Srabon-bot/Aquaguard/new_models/new_approach/model_1_flood/AquaShield_Capstone_Project_Report_Humanized.md

 AquaShield: Intelligent Aquaculture Monitoring and
Adaptive Protection System Using Machine Learning and
                          IoT
                                                 By

                   Md. Shahriar Hossain Srabon (ID: 0432310005101056)
                             Md. Mahfuz (ID: 0432310005101057)
                             Hrithik Saha (ID: 0432310005101071)

                      Department of Computer Science and Engineering

                              Faculty of Science and Engineering

A Capstone Project Submitted in partial fulfillment of the requirements for the degree of Bachelor of
                           Science in Computer Science and Engineering

                                          Supervised By

                                     Sultana Rokeya Naher

                                        Associate Professor

                         Department of Computer Science and Engineering

             University of Information Technology and Sciences (UITS)
                                  Baridhara J Block, Dhaka 1212

                                           October, 2026

Declaration
The capstone project work entitled "AquaShield: Intelligent Aquaculture Monitoring and
Adaptive Protection System Using Machine Learning and IoT" is a authentic record of work
carried out by Md. Shahriar Hossain Srabon (ID: 0432310005101056), Md. Mahfuz (ID:
0432310005101057), and Hrithik Saha (ID: 0432310005101071) under the supervision of
Sultana Rokeya Naher, Associate Professor, Department of Computer Science and Engineering
(CSE), University of Information Technology and Sciences (UITS), Dhaka, Bangladesh.

This work, in whole or in part, has not been submitted elsewhere for the award of any degree or
diploma.

Candidates:

------------------------------------------------------------------------

➢ Md. Shahriar Hossain Srabon

Student ID: 0432310005101056

Department of Computer Science and Engineering, UITS

------------------------------------------------------------------------

➢ Md. Mahfuz

Student ID: 0432310005101057

Department of Computer Science and Engineering, UITS

------------------------------------------------------------------------

➢ Hrithik Saha

Student ID: 0432310005101071

Department of Computer Science and Engineering, UITS

Approval
This is to certify that the capstone project work submitted by Md. Shahriar Hossain Srabon
(ID: 0432310005101056), Md. Mahfuz (ID: 0432310005101057), and Hrithik Saha
(ID: 0432310005101071) entitled "AquaShield: Intelligent Aquaculture Monitoring and Adaptive
Protection System Using Machine Learning and IoT" has been examined and approved by the
Capstone Project Review Committee in partial fulfillment of the requirements for the degree of
Bachelor of Science in Computer Science and Engineering (CSE) in the Department of Computer
Science and Engineering (CSE), University of Information Technology and Sciences (UITS),
Dhaka, Bangladesh in Autumn 2026.

                                                          2

CAPSTONE PROJECT REVIEW COMMITTEE

➢ ................................................................

[Head of Department Name]

Head of the Department

Department of Computer Science and Engineering (CSE)

University of Information Technology and Sciences (UITS)

(Convener)

➢ ................................................................

Sultana Rokeya Naher

Associate Professor

Department of Computer Science and Engineering (CSE)

University of Information Technology and Sciences (UITS)

(Supervisor)

➢ ................................................................

[External Examiner Name]

Professor / External Expert

Department of Computer Science and Engineering

University of Information Technology and Sciences (UITS)

(Member)

➢ ................................................................

[Internal Coordinator Name]

Coordinator, Capstone Project Committee

Department of Computer Science and Engineering (CSE)

University of Information Technology and Sciences (UITS)

(Member Secretary)

                                                                      3

Acknowledgement - done

We would like to express our gratitude to Almighty Allah for providing us with the patience,
health and capacity to finish our capstone engineering project.

We would like to thank our supervisor Sultana Rokeya Naher, Associate Professor, Computer
Science and Engineering, University of Information Technology and Sciences (UITS) for her
guidance and support. Her constant guidance, frequent feedback and encouragement helped us to
tackle the actual hardware problems, design the right database and validate our machine learning
models properly.

We are also grateful to the Head of the Department of Computer Science and Engineering, and
our teachers and laboratory staff at UITS for the support and facilities provided to us during the
study in the Department.

The Bangladesh Water Development Board (BWDB) and Flood Forecasting and Warning Centre
(FFWC) have been providing historical records of river gauges, which is greatly appreciated. We
also would like to thank Open-Meteo for supplying the free catchment rainfall data from ERA5.

Last but not the least, we would like to thank our parents and relatives for their constant support
and sacrifices throughout our college days. We also thank each other for working together as a
team with dedication to build AquaShield.

Justification Report
Below is the Course Outcome to Program Outcome (CO-PO) Mapping, Justification of PO
through COs, Complex Engineering Problem (CEP) Justification, and Range of Complex
Engineering Activities (CEA) Report for our project titled "AquaShield: Intelligent Aquaculture
Monitoring and Adaptive Protection System Using Machine Learning and IoT".

CO-PO Mapping
CO-PO Mapping Matrix for AquaShield

  CO No.             Description of CO        KP               CP              CA
                     Apply engineering
                     fundamentals and
                     computing
                     knowledge to
                     identify and translate
                     real-life aquaculture
  CO1                                         K1, K2, K3, K4   -               -
                     water quality
                     problems and
                     monsoon flood
                     threats into an
                     intelligent IoT and
                     ML solution.

                                                      4

CO No.   Description of CO       KP           CP              CA
         Identify, formulate,
         and analyze water
         quality requirements
         (pH, TDS,
         temperature, depth)
CO2                              K2, K3, K4   WP1, WP2, WP3   -
         and flood threshold
         limits to reach
         substantiated
         conclusions using
         data.
         Design and build an
         integrated system
         combining an ESP32
         sensor node, local
CO3      relay control logic,    K3, K5, K6   WP1, WP3, WP5   -
         cloud data storage,
         and machine
         learning prediction
         models.
         Select and apply
         modern hardware
         and software tools
         including ESP32,
         Arduino C++,
CO4                              K3, K5, K6   WP1, WP3, WP4   -
         Firebase Realtime
         Database, Python
         FastAPI,
         Scikit-learn, and
         XGBoost.
         Function effectively
         as individual
         contributors and as a
         3-member
CO5                              -            -               -
         engineering team
         with clear task
         distribution and
         regular coordination.
         Demonstrate project
         management and
         budgeting skills by
         keeping the total
CO6                              -            -               -
         prototype hardware
         cost under 7,200
         BDT (~\$60) for
         rural fish farmers.
         Conduct
         experimental
         investigations using
         laboratory buffer
         solutions for sensor
CO7                              K6, K8       WP1, WP2, WP3   -
         calibration and 15
         years of river data
         with
         Leave-One-Year-Out
         validation.
         Assess the
         real-world impact of
         the project on rural
         aquaculture,
CO8                              K8, K7       WP1, WP3, WP4   -
         protecting fish from
         mortality and saving
         farmers from severe
         financial loss.

                                          5

  CO No.            Description of CO       KP       CP                  CA
                    Evaluate
                    environmental
                    sustainability by
                    minimizing water
  CO9               pumping, preventing     K7       -                   -
                    chemical
                    over-concentration,
                    and avoiding feed
                    wastage.
                    Commit to
                    professional
                    engineering ethics by
                    reporting true
                    empirical results,
  CO10                                      K7       -                   -
                    citing all references
                    properly, and
                    explaining model
                    predictions with
                    SHAP.
                    Communicate
                    engineering work
                    clearly through a
                                                                         EA1, EA2, EA3,
  CO11              complete written        -        -
                                                                         EA5
                    technical project
                    book and oral
                    defense presentation.
                    Recognize the need
                    for lifelong learning
                    by researching future
                    system extensions
  CO12                                      -        -                   -
                    like on-device
                    TinyML and
                    LoRaWAN wireless
                    networks.

Justification of PO through COs
Justification of PO through COs for AquaShield

                                                          Justification (with Specific Report
  CO No.                           PO
                                                          References)
                                                          We applied basic electronics, sensor
                                                          physics (Nernst equation for pH,
                                                          electrical conductivity for TDS,
                                                          ultrasonic time-of-flight), and
  CO1                              PO1                    machine learning regression to solve
                                                          real-world pond water deterioration
                                                          and river flood overflow in
                                                          Bangladesh. (Reported in Section
                                                          1.2, 3.3, and 3.6).
                                                          We formulated the technical
                                                          requirements for pond water
                                                          monitoring and river flood warnings,
                                                          defining mathematical conversion
  CO2                              PO2                    formulas, 1-hour TDS lag features,
                                                          and water danger thresholds
                                                          evaluated using RMSE, MAE, and
                                                          NSE metrics. (Reported in Section
                                                          1.3, 3.6, and 5.3).

                                                 6

                    Justification (with Specific Report
CO No.   PO
                    References)
                    We designed and assembled the
                    complete system: an ESP32 edge
                    node with optocoupler-isolated
                    relays, local autonomous FSM rules
                    for the pumps and the servo feeder, a
CO3      PO3
                    Firebase Realtime Database cloud
                    layer, and three machine learning
                    models served by a Python FastAPI
                    backend. (Reported in Chapters 3
                    and 4).
                    We selected and used standard
                    modern engineering tools including
                    ESP32 32-bit MCU,
                    PlatformIO/Arduino IDE, Firebase
CO4      PO5
                    Realtime Database, Python FastAPI,
                    Python Scikit-learn, XGBoost, and
                    SHAP. (Reported in Section 4.2 to
                    4.6).
                    Our 3-member team divided tasks
                    effectively: Srabon handled hardware
                    fabrication and power wiring,
                    Mahfuz integrated the ESP32 with
                    the Firebase Realtime Database and
CO5      PO9
                    built the web dashboard, and Hrithik
                    developed the Python FastAPI
                    backend and the ML flood
                    forecasting and anomaly detection
                    models. (Reported in Section 4.1).
                    We managed component
                    procurement and prepared a detailed
                    Bill of Materials totaling 6,570 BDT
CO6      PO11       (\$55.15 USD), proving our system is
                    affordable for marginal fish farmers
                    in Bangladesh. (Reported in Section
                    3.3, Table 3.1).
                    We conducted practical
                    investigations: we calibrated the pH
                    sensor with vinegar (pH 2.4) and
                    baking soda (pH 8.3) reference
                    solutions, evaluated sensor accuracy
                    against standard buffer solutions, and
CO7      PO4
                    validated our river flood model on 15
                    years (2008--2022) of BWDB
                    records using Leave-One-Year-Out
                    (LOYO) cross-validation to prevent
                    data leakage. (Reported in Section
                    3.3, 3.7, 5.2, and 5.3).
                    We evaluated the socioeconomic
                    impact on rural communities:
                    preventing fish kills protects farmer
                    income, safeguards food security,
CO8      PO6
                    and avoids financial devastation
                    during monsoon river overflows.
                    (Reported in Section 1.1, 2.2, and
                    6.1).
                    We designed closed-loop control
                    rules that save water by pumping
                    only when necessary, prevent pond
CO9      PO7        pollution from excess feed, and use
                    energy-efficient 12V DC power
                    components. (Reported in Section
                    3.4 and 4.2).

                7

                                                                   Justification (with Specific Report
  CO No.                       PO
                                                                   References)
                                                                   We maintained academic honesty by
                                                                   using real observed datasets,
                                                                   reporting actual prediction errors
  CO10                         PO8                                 without bias, explaining tree
                                                                   predictions via SHAP, and properly
                                                                   citing all literature. (Reported in
                                                                   Section 5.4, 5.7, and References).
                                                                   We wrote this complete,
                                                                   well-documented technical capstone
                                                                   report adhering to UITS and IEEE
                                                                   standards, created 13 figures (Figure
  CO11                         PO10
                                                                   3.1 to Figure 5.11) and 15 numbered
                                                                   tables, and prepared slides for our
                                                                   oral defense. (Reported throughout
                                                                   the entire book and the report).
                                                                   We recognized that technology
                                                                   continues to evolve, so we studied
                                                                   and documented future upgrade paths
  CO12                         PO12                                including running TinyML directly
                                                                   on the ESP32 and adding LoRaWAN
                                                                   mesh networking. (Reported in
                                                                   Section 6.2).

Complex Engineering Problem (CEP) Justification
Complex Engineering Problem (CEP) Justification Matrix

                                                                   BAETE Criteria [24] & Project
  Attribute Category           Attribute Name & ID                 Justification (with Report
                                                                   References)
                                                                   Solving this problem required
                                                                   knowledge from multiple
                                                                   engineering fields (K4): embedded
                                                                   systems (ADC oversampling,
                                                                   voltage-divider interfacing, 3.3V
                                                                   analog sensor design), cloud data
                                                                   handling (Firebase Realtime
  1. Mandatory Attribute       Depth of Knowledge (P1)             Database, Python FastAPI REST
                                                                   services), time-series machine
                                                                   learning, and Explainable AI
                                                                   (SHAP). We studied research
                                                                   literature (K8) to handle time-series
                                                                   data leakage and peak extrapolation.
                                                                   (Reported in Section 2.4, 2.5, 3.6,
                                                                   5.3).
                                                                   We balanced conflicting constraints:
                                                                   low hardware cost (<\$60) vs. good
                                                                   sensor accuracy; real-time cloud
                               Range of Conflicting Requirements   updates vs. frequent rural internet
  2. Supporting Attribute
                               (P2)                                dropouts; and long flood forecast
                                                                   horizons (+14 days) vs. growing
                                                                   prediction error. (Reported in Section
                                                                   1.2, 3.4, 5.6).

                                               8
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
