Srabon-bot/Aquaguard/new_models/AquaGuard — Machine Learning Module PRD.md

## AquaGuard — Machine Learning Module

## Product Requirements Document (PRD)

Project: AquaGuard — Bangladesh Flood Early Warning and IoT Pond Management System

Document Type: Machine Learning Module PRD

Primary Users: Aquaculture farmers / pond operators

Implementation Level: Undergraduate / beginner-friendly ML project

Target: A practical, explainable ML system integrated with the existing AquaGuard IoT dashboard

## 1. Project Overview

AquaGuard is an IoT-based pond-management and flood-awareness system for aquaculture environments in Bangladesh.

The existing system contains:

- ESP32-based pond monitoring

- pH sensing

- TDS/water-quality sensing
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
