Srabon-bot/Aquaguard/added figs/1.1.png

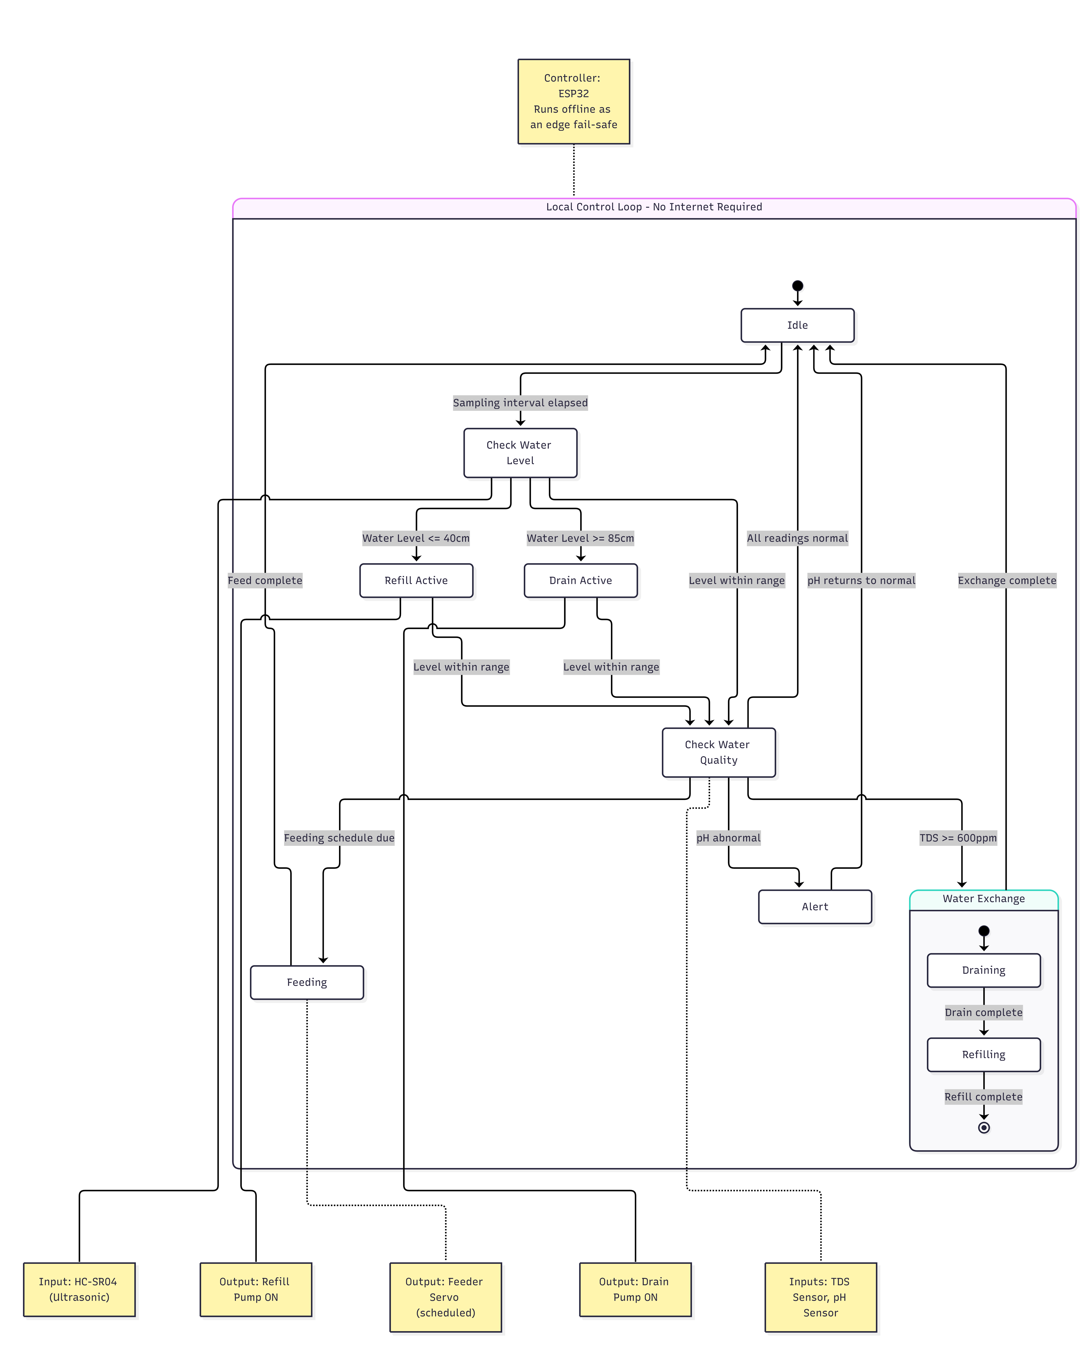
added figs/1.1.png
