Srabon-bot/Aquaguard/added figs/1.2.png

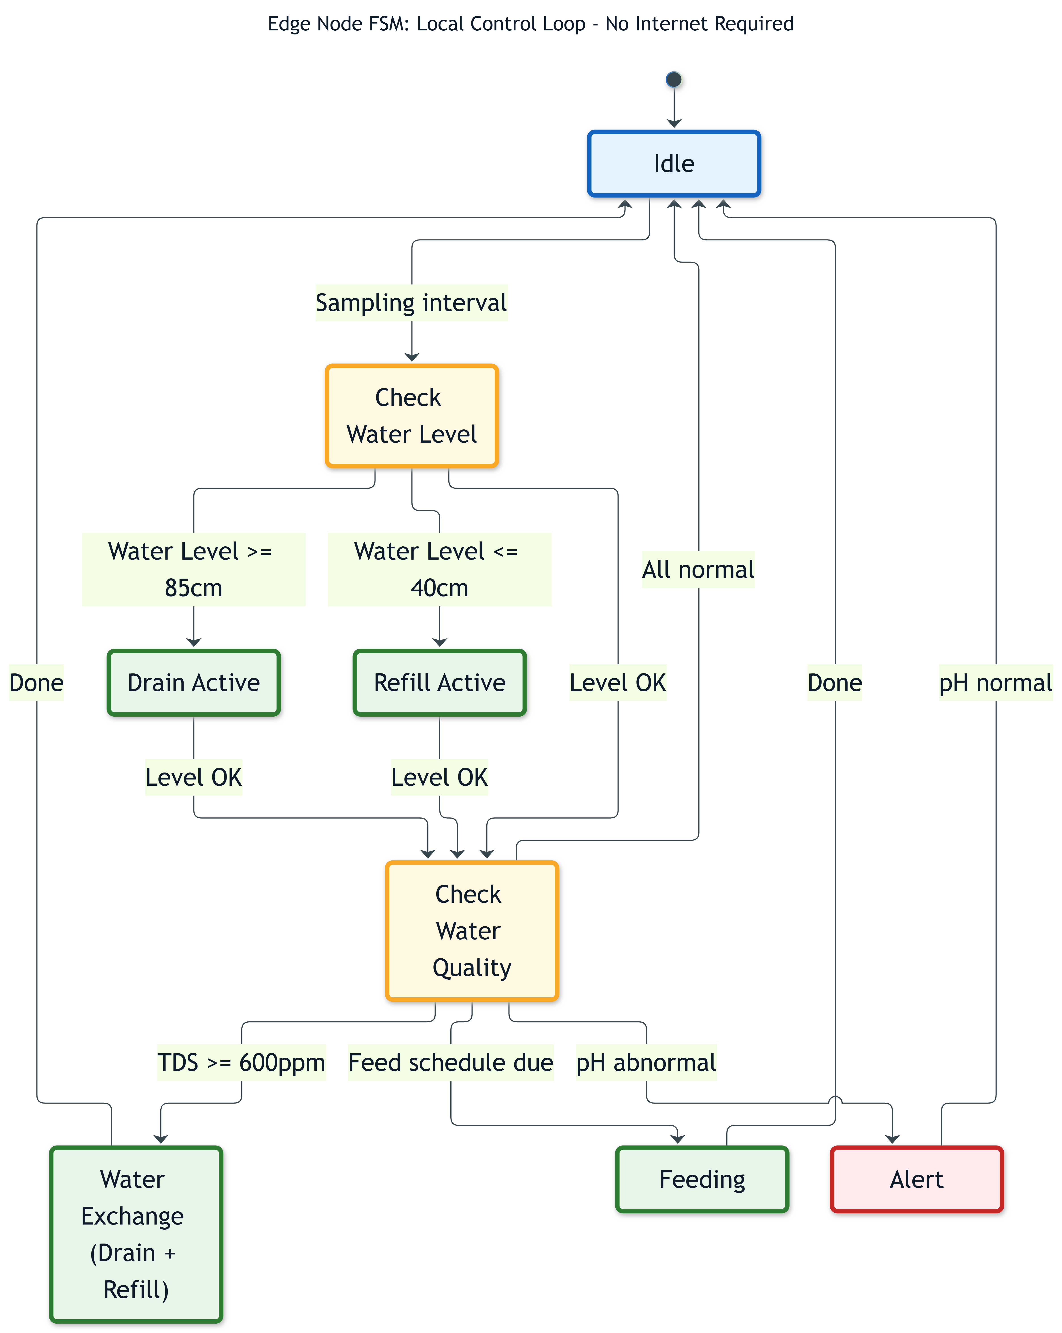
added figs/1.2.png
