Srabon-bot/Aquaguard/added figs/2.1.r-2026-10-06-072004.png

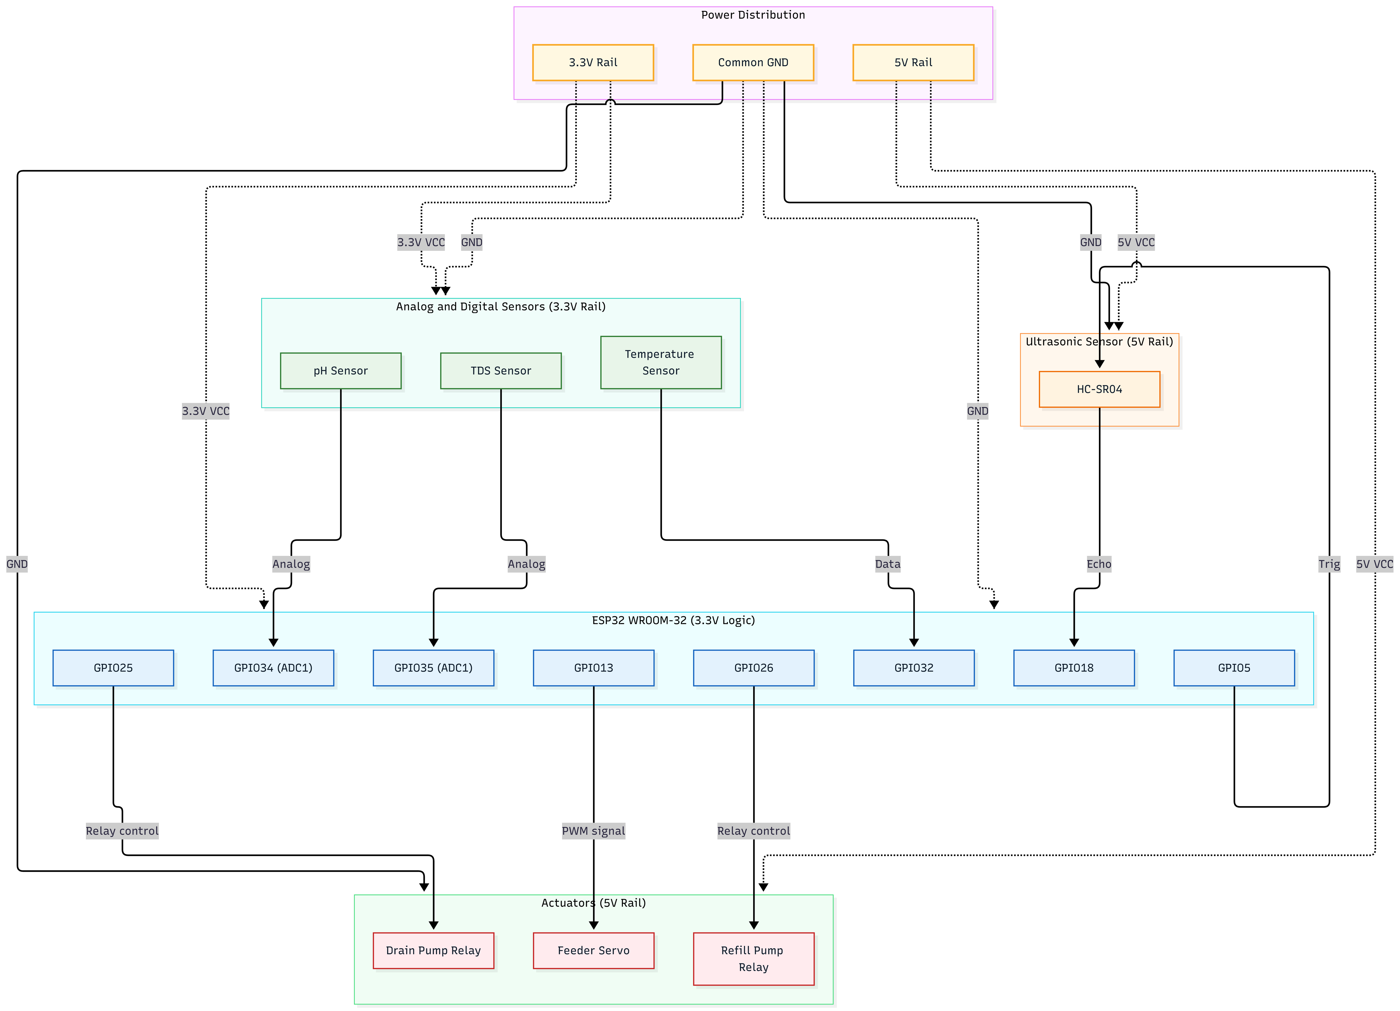
added figs/2.1.r-2026-10-06-072004.png
