Srabon-bot/Aquaguard/added figs/2.2.p-2026-10-06-072031.png

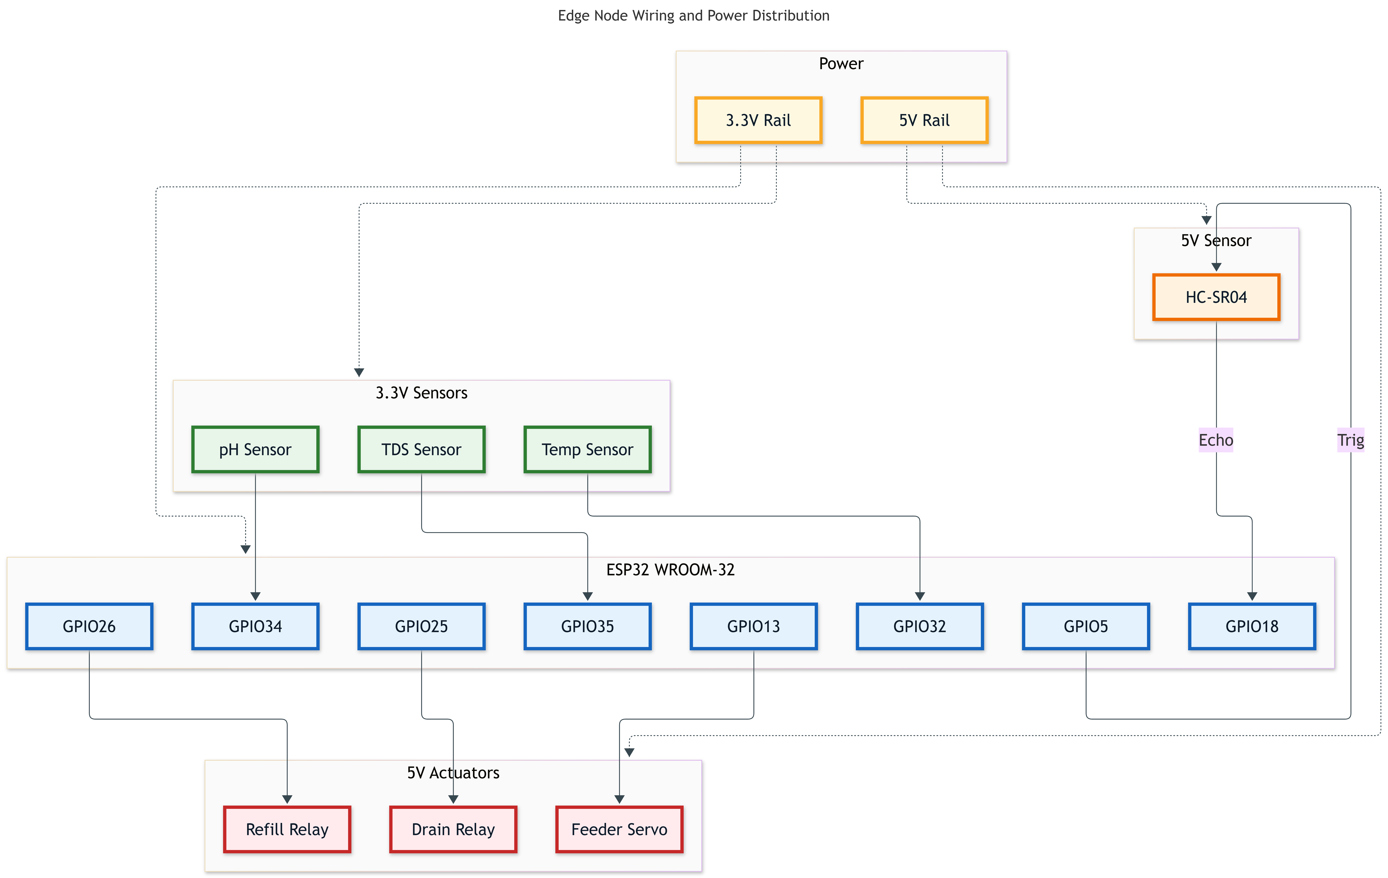
added figs/2.2.p-2026-10-06-072031.png
