Srabon-bot/Aquaguard/added figs/3.1.r-2026-10-06-072122.png

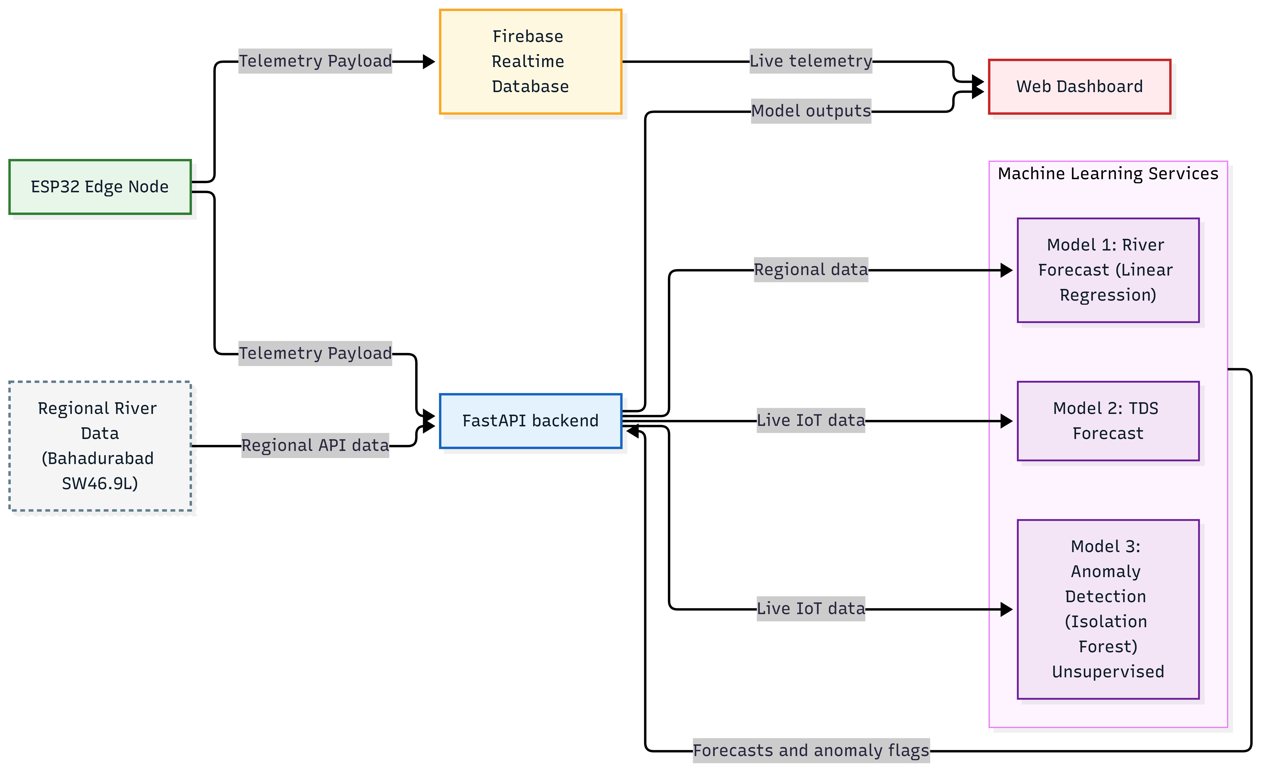
added figs/3.1.r-2026-10-06-072122.png
