Srabon-bot/Aquaguard/added figs/3.2.p-2026-10-06-072148.png

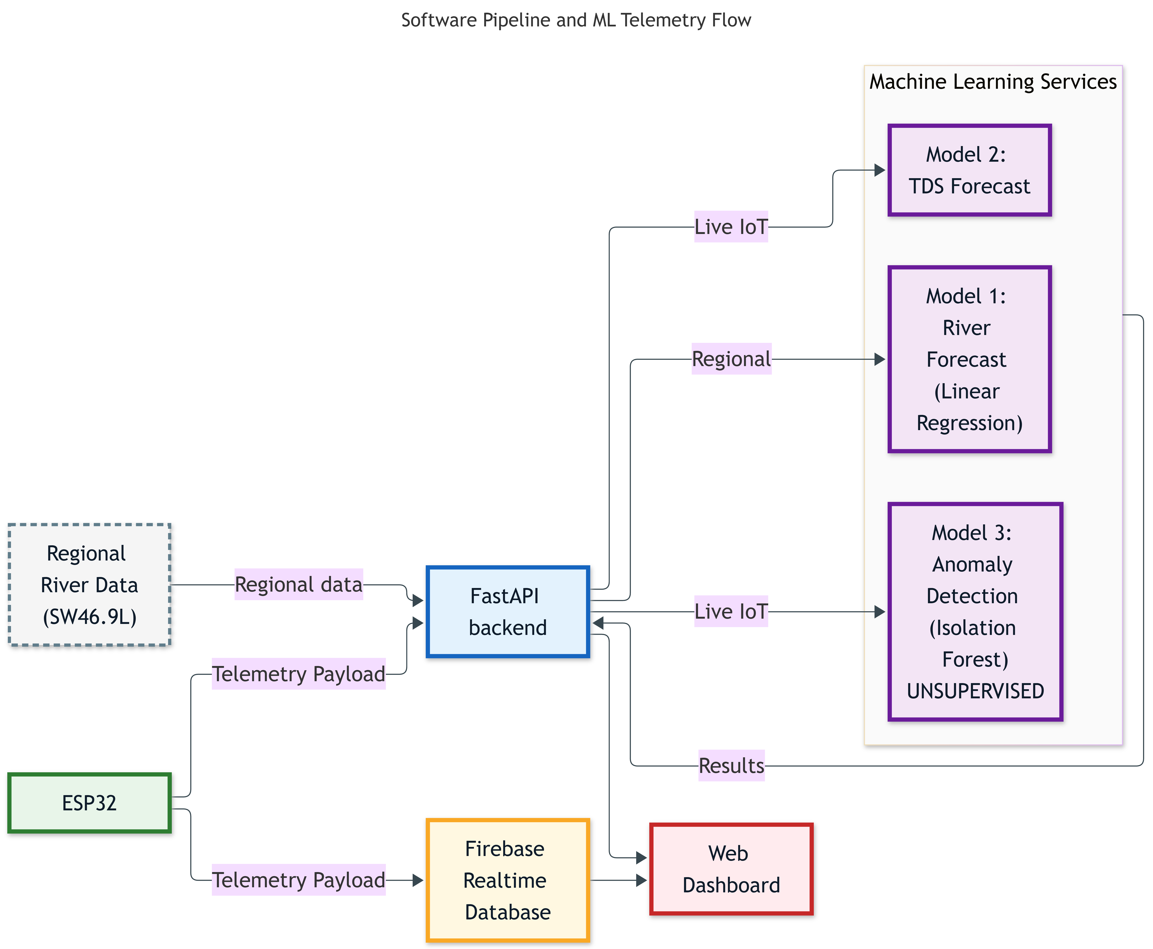
added figs/3.2.p-2026-10-06-072148.png
