Srabon-bot/Aquaguard/added figs/5.1.R-2026-10-06-071544.png

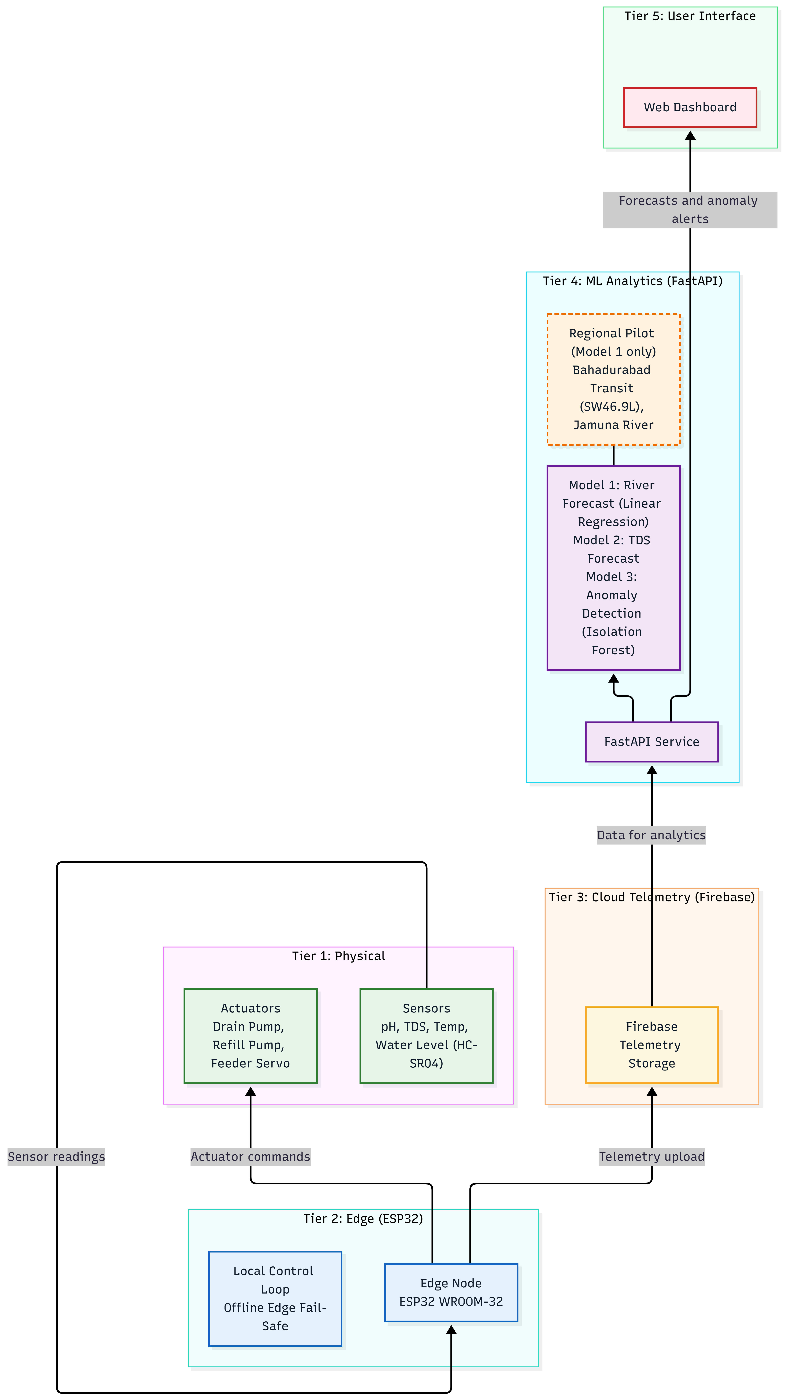
added figs/5.1.R-2026-10-06-071544.png
