Srabon-bot/Aquaguard/added figs/5.2.p-2026-10-06-071613.png

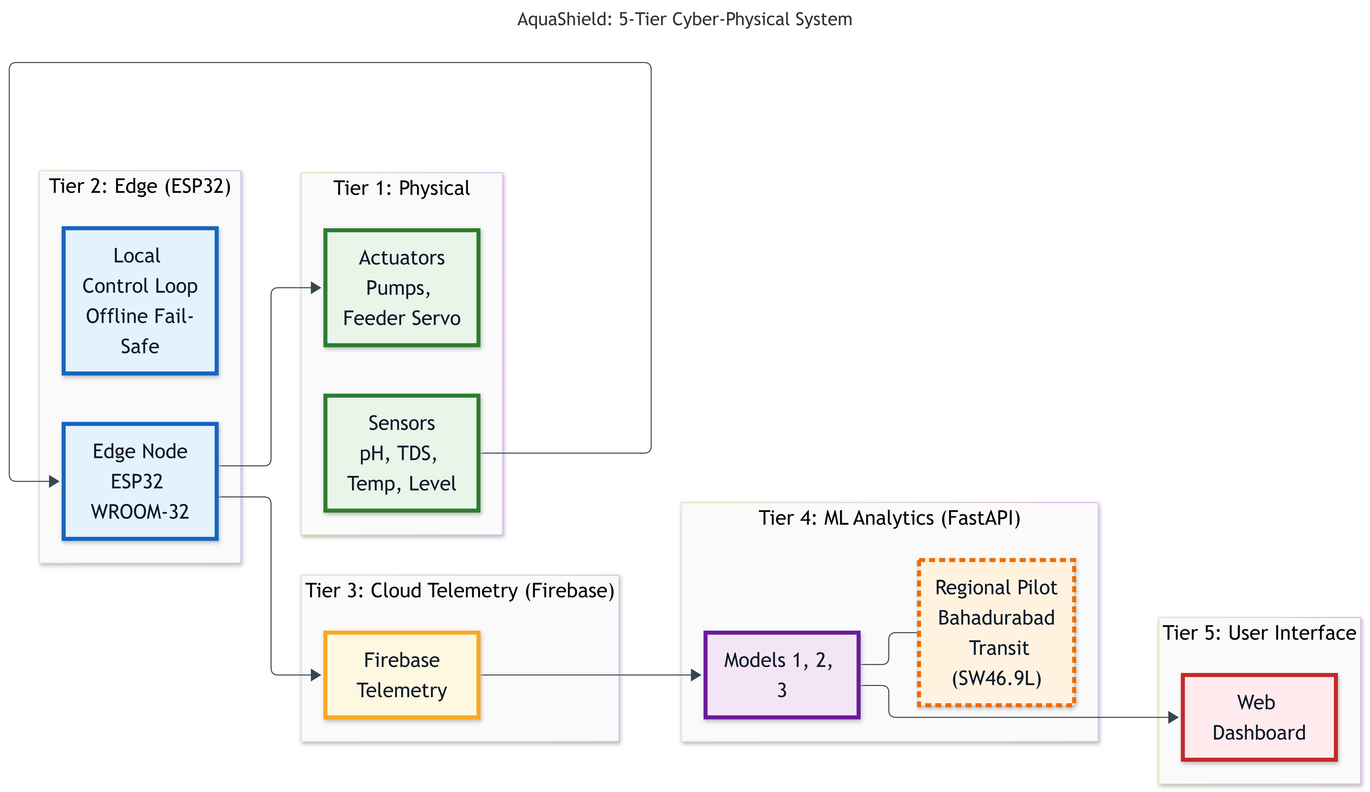
added figs/5.2.p-2026-10-06-071613.png
