Srabon-bot/Aquaguard/AquaGuard_Final_Release/software/backend/model_1_flood/outputs/figures/F01_full_wl_series.png

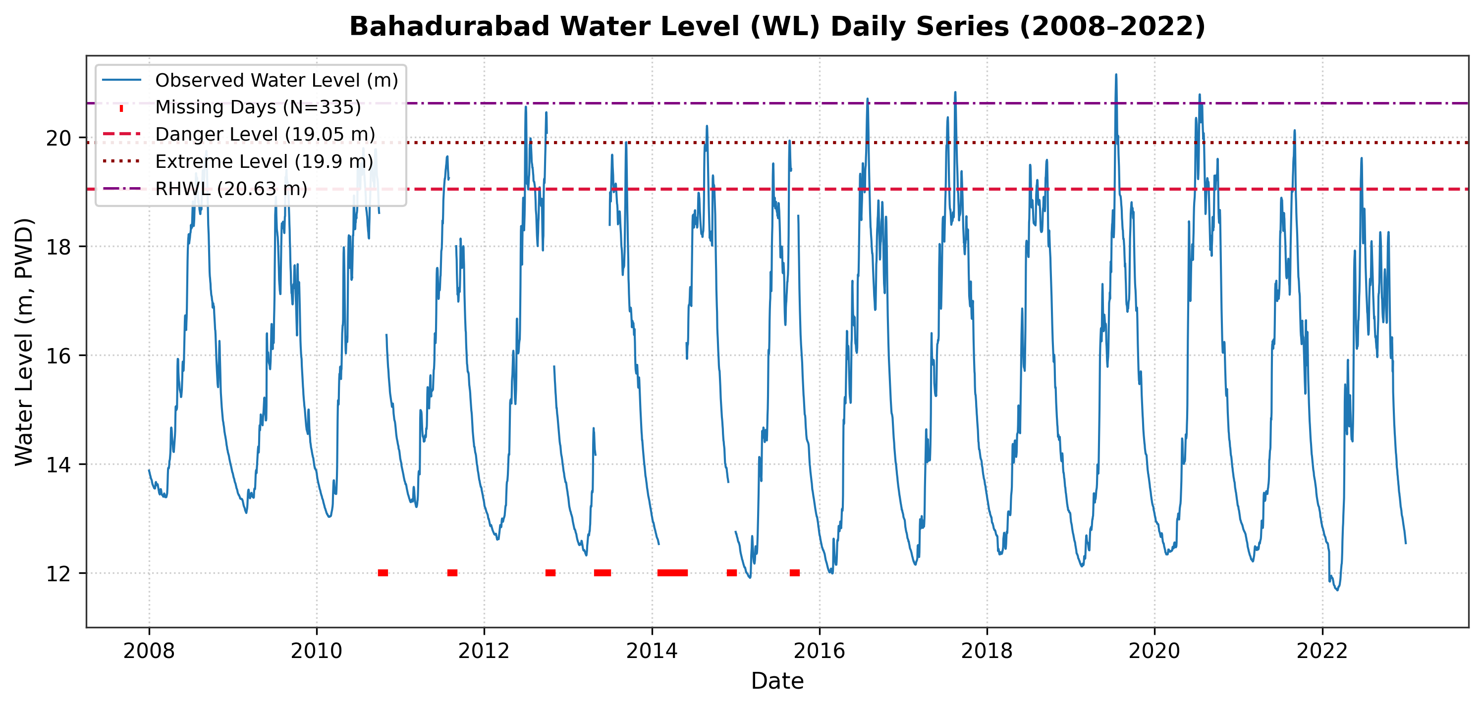
AquaGuard_Final_Release/software/backend/model_1_flood/outputs/figures/F01_full_wl_series.png
