Srabon-bot/Aquaguard/AquaGuard_Final_Release/software/backend/model_1_flood/outputs/figures/F02_missing_data_heatmap.png

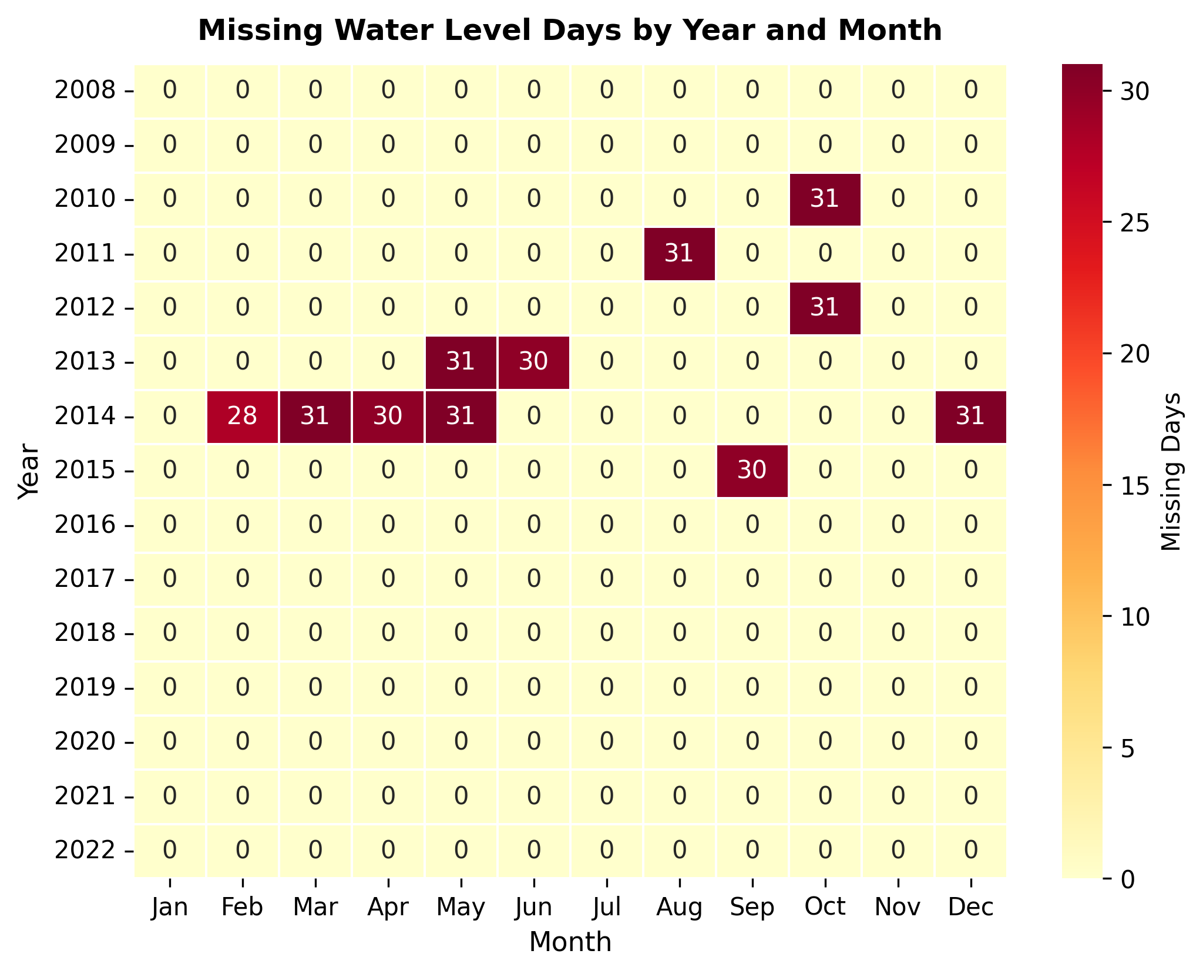
AquaGuard_Final_Release/software/backend/model_1_flood/outputs/figures/F02_missing_data_heatmap.png
