Srabon-bot/Aquaguard/AquaGuard_Final_Release/software/backend/model_1_flood/outputs/figures/F03_annual_maxima_comparison.png

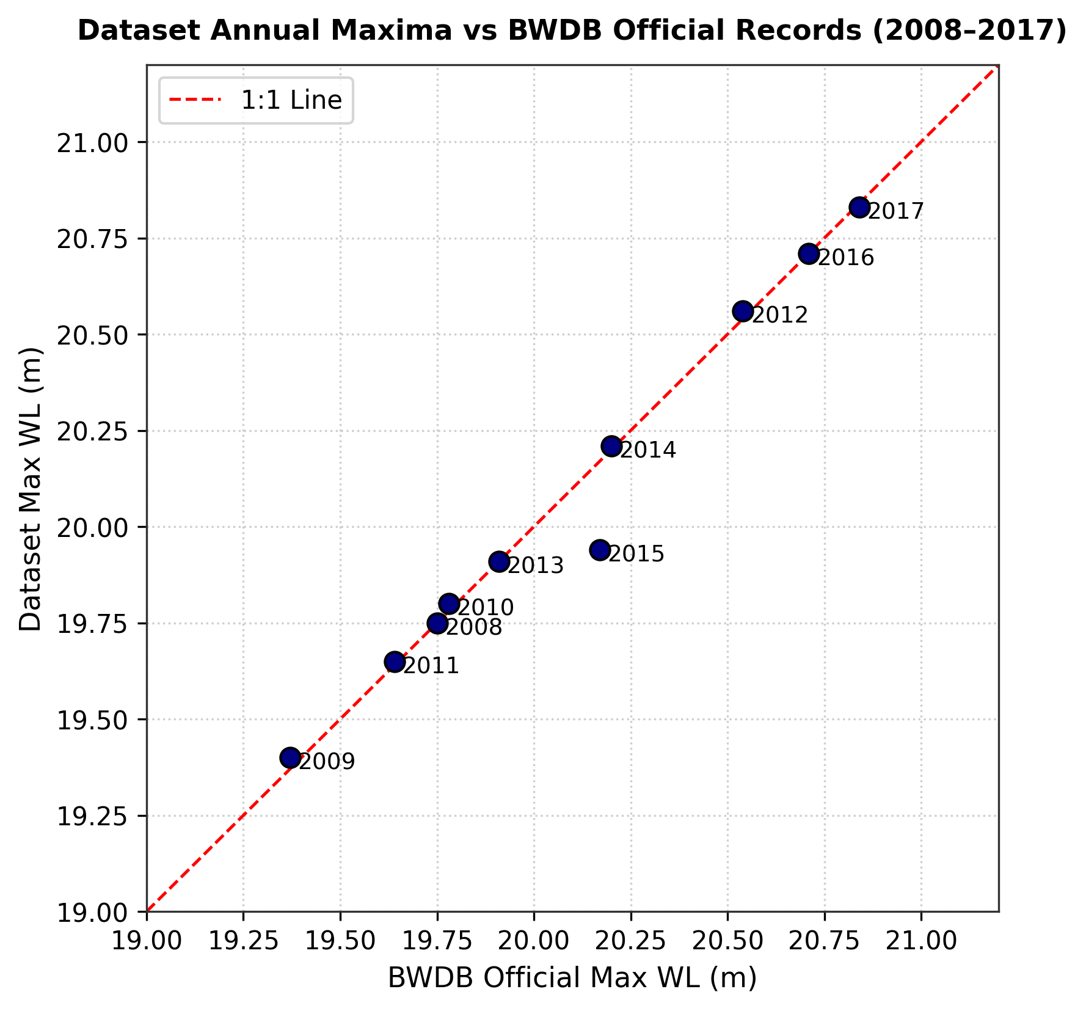
AquaGuard_Final_Release/software/backend/model_1_flood/outputs/figures/F03_annual_maxima_comparison.png
