Srabon-bot/Aquaguard/AquaGuard_Final_Release/software/backend/model_1_flood/outputs/figures/F04_seasonal_cycle_and_peaks.png

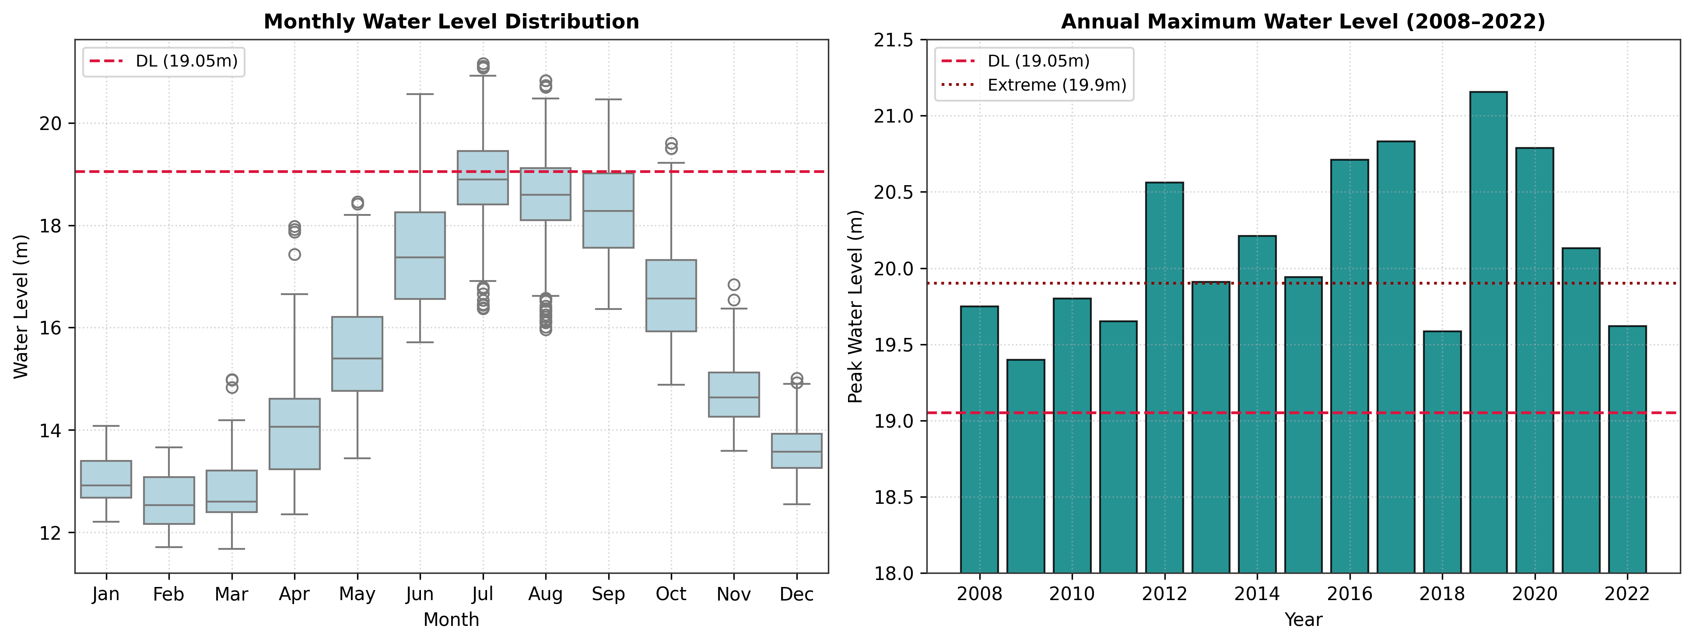
AquaGuard_Final_Release/software/backend/model_1_flood/outputs/figures/F04_seasonal_cycle_and_peaks.png
