Srabon-bot/Aquaguard/AquaGuard_Final_Release/software/backend/model_1_flood/outputs/figures/F05_flood_events_timeline_histogram.png

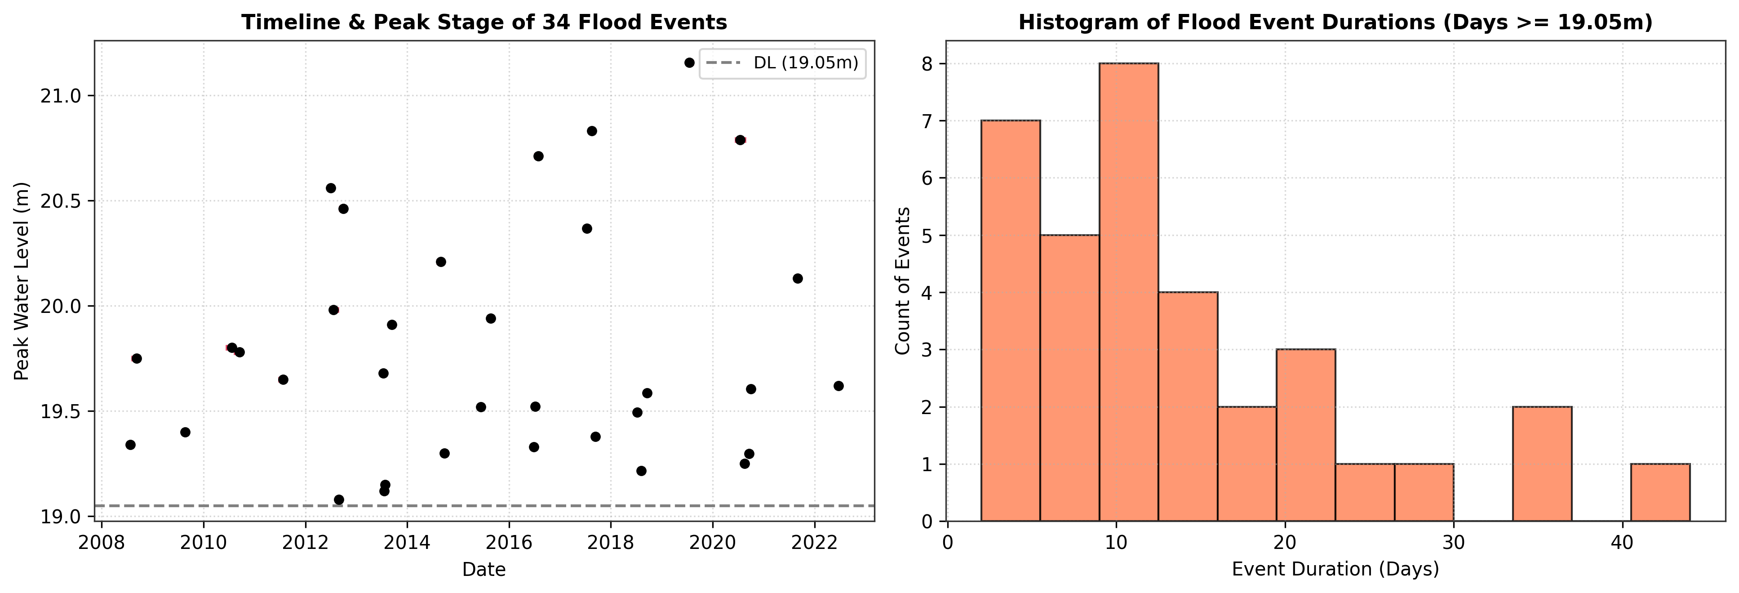
AquaGuard_Final_Release/software/backend/model_1_flood/outputs/figures/F05_flood_events_timeline_histogram.png
