Srabon-bot/Aquaguard/AquaGuard_Final_Release/software/backend/model_1_flood/outputs/figures/F06_acf_pacf_wl.png

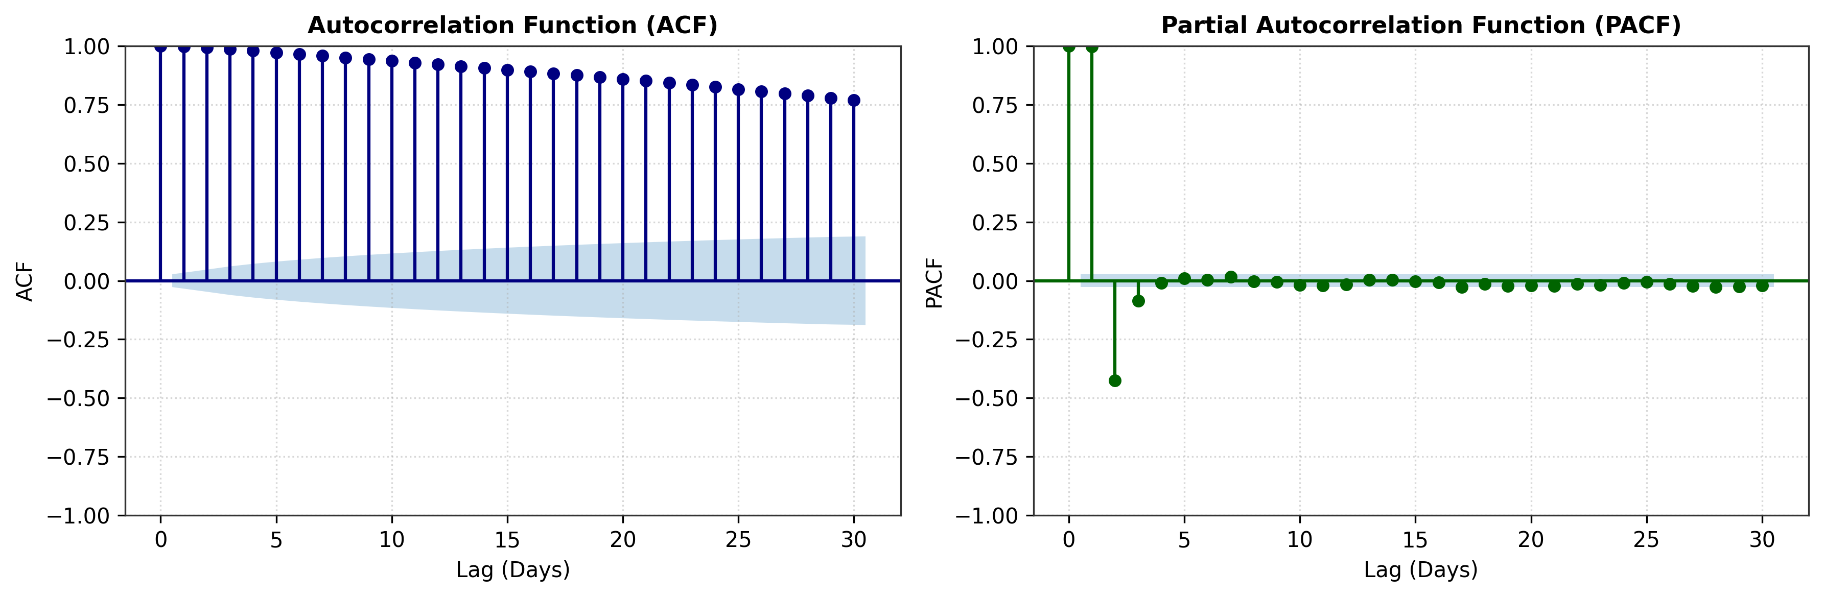
AquaGuard_Final_Release/software/backend/model_1_flood/outputs/figures/F06_acf_pacf_wl.png
