Srabon-bot/Aquaguard/AquaGuard_Final_Release/software/backend/model_1_flood/outputs/figures/F07_rating_curve_wl_vs_q.png

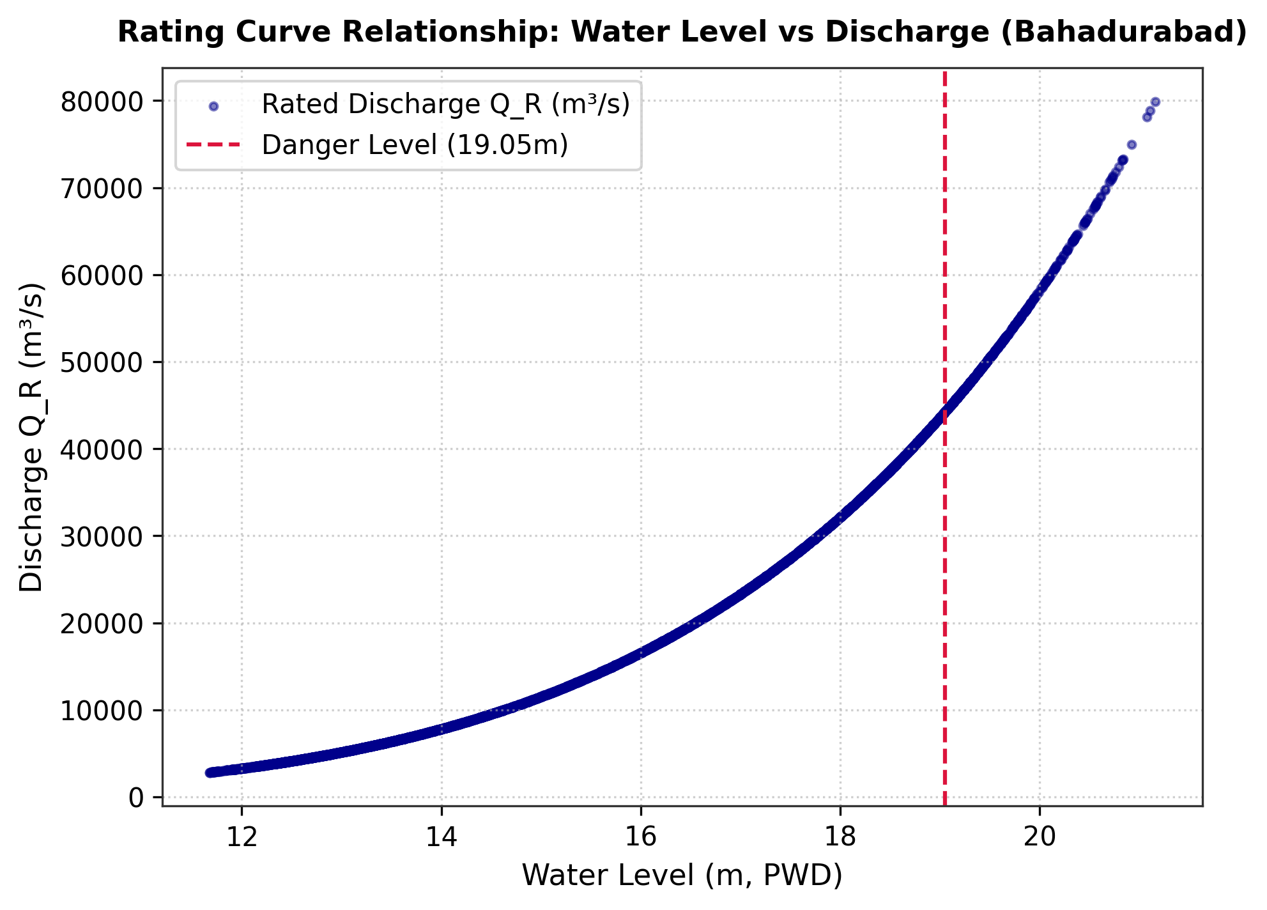
AquaGuard_Final_Release/software/backend/model_1_flood/outputs/figures/F07_rating_curve_wl_vs_q.png
