Srabon-bot/Aquaguard/AquaGuard_Final_Release/software/backend/model_1_flood/outputs/figures/F11_baseline_comparison_h1.png

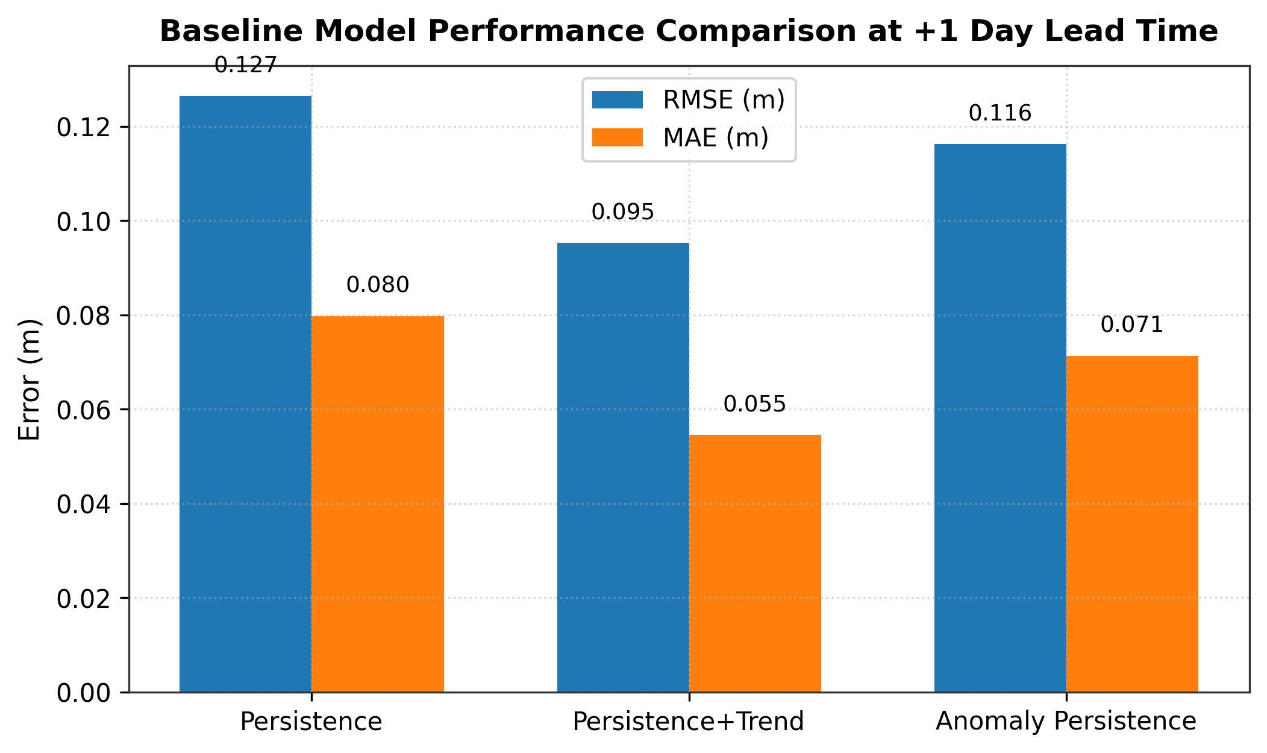
AquaGuard_Final_Release/software/backend/model_1_flood/outputs/figures/F11_baseline_comparison_h1.png
