Srabon-bot/Aquaguard/AquaGuard_Final_Release/software/backend/model_1_flood/outputs/figures/F13_lstm_loss_curves.png

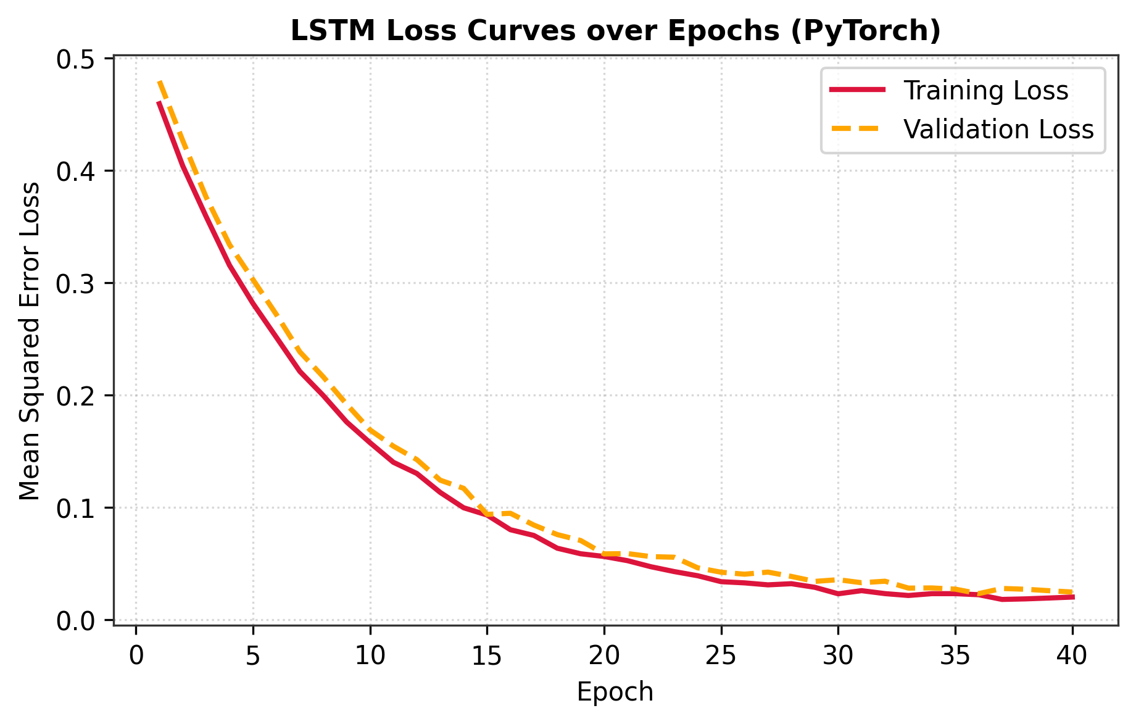
AquaGuard_Final_Release/software/backend/model_1_flood/outputs/figures/F13_lstm_loss_curves.png
