Srabon-bot/Aquaguard/AquaGuard_Final_Release/software/backend/model_1_flood/outputs/figures/F15_skill_vs_lead_time.png

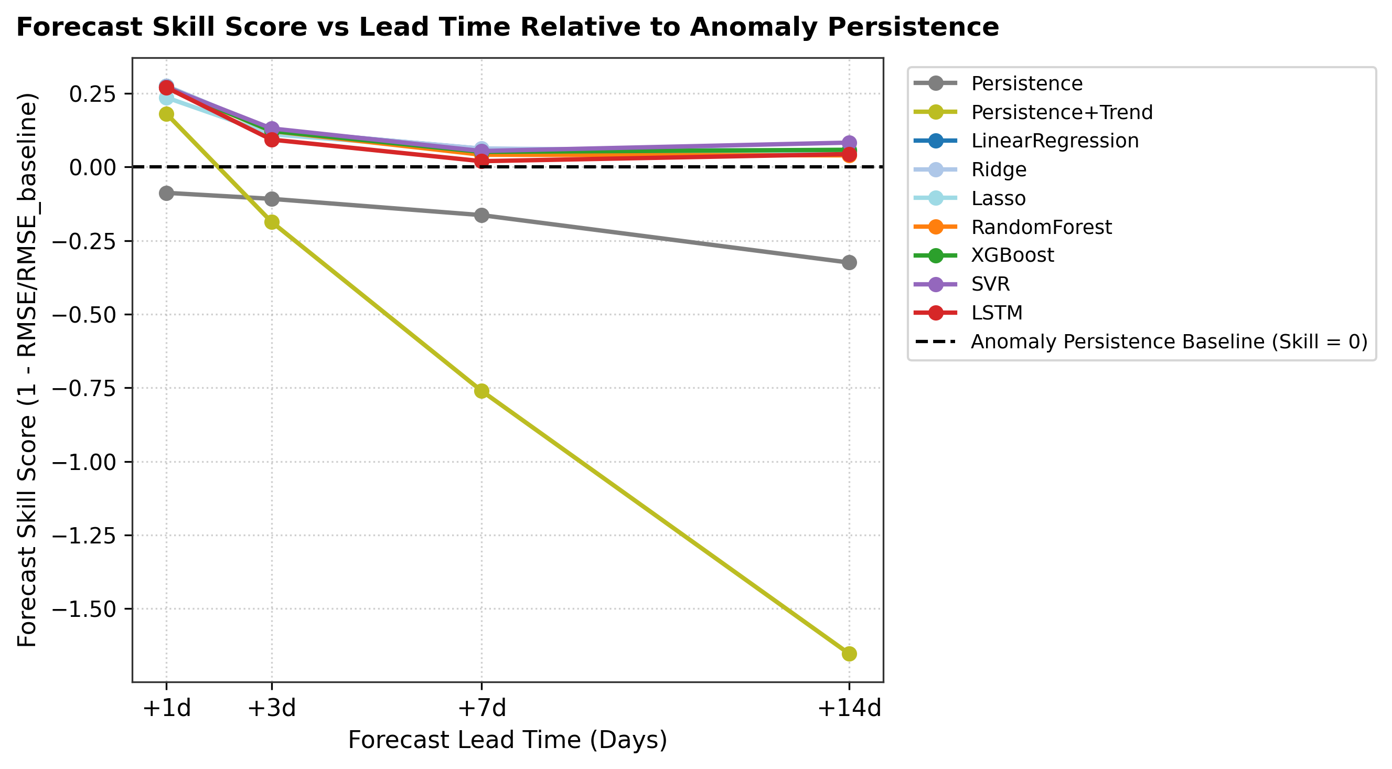
AquaGuard_Final_Release/software/backend/model_1_flood/outputs/figures/F15_skill_vs_lead_time.png
