Srabon-bot/Aquaguard/AquaGuard_Final_Release/software/backend/model_1_flood/outputs/figures/F16_per_year_rmse_boxplots.png

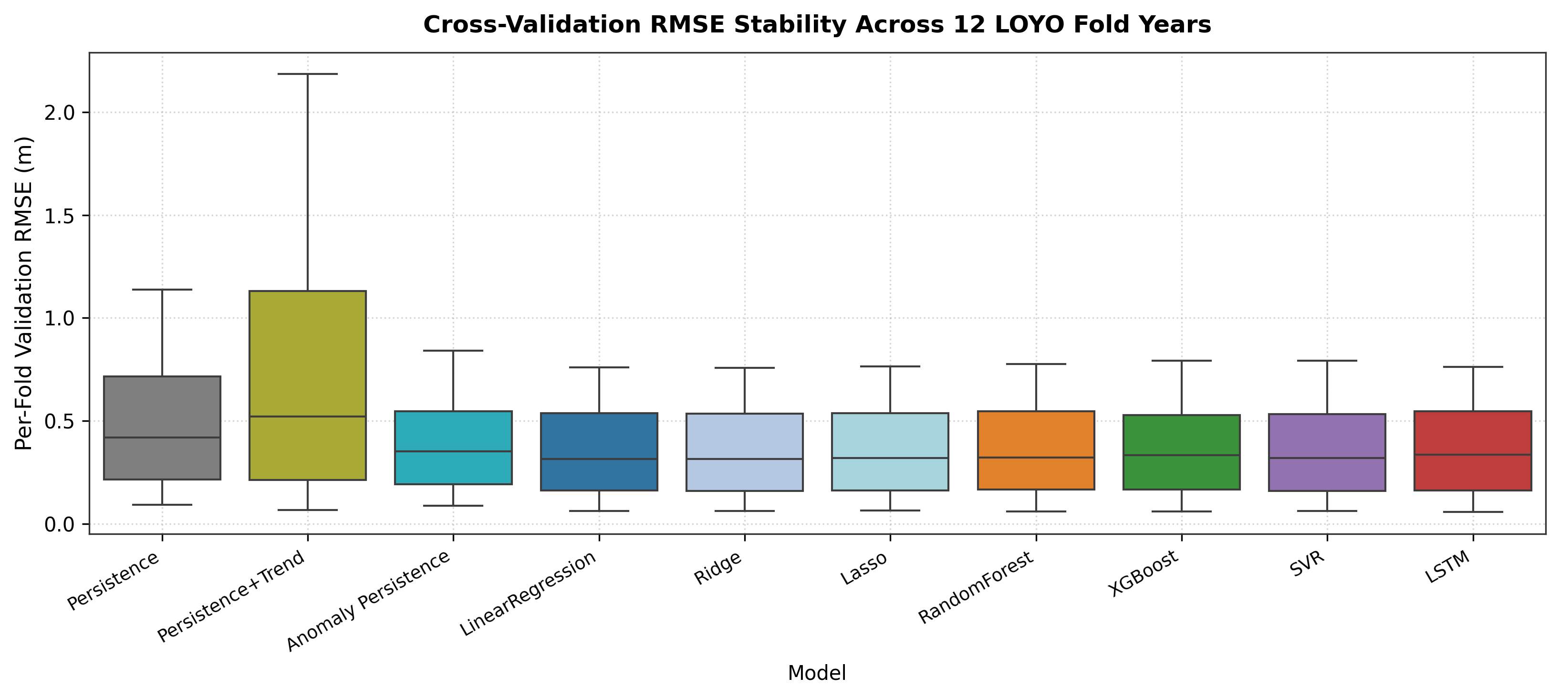
AquaGuard_Final_Release/software/backend/model_1_flood/outputs/figures/F16_per_year_rmse_boxplots.png
