Srabon-bot/Aquaguard/AquaGuard_Final_Release/software/backend/model_1_flood/outputs/figures/F17_feature_ablation_a_b_c.png

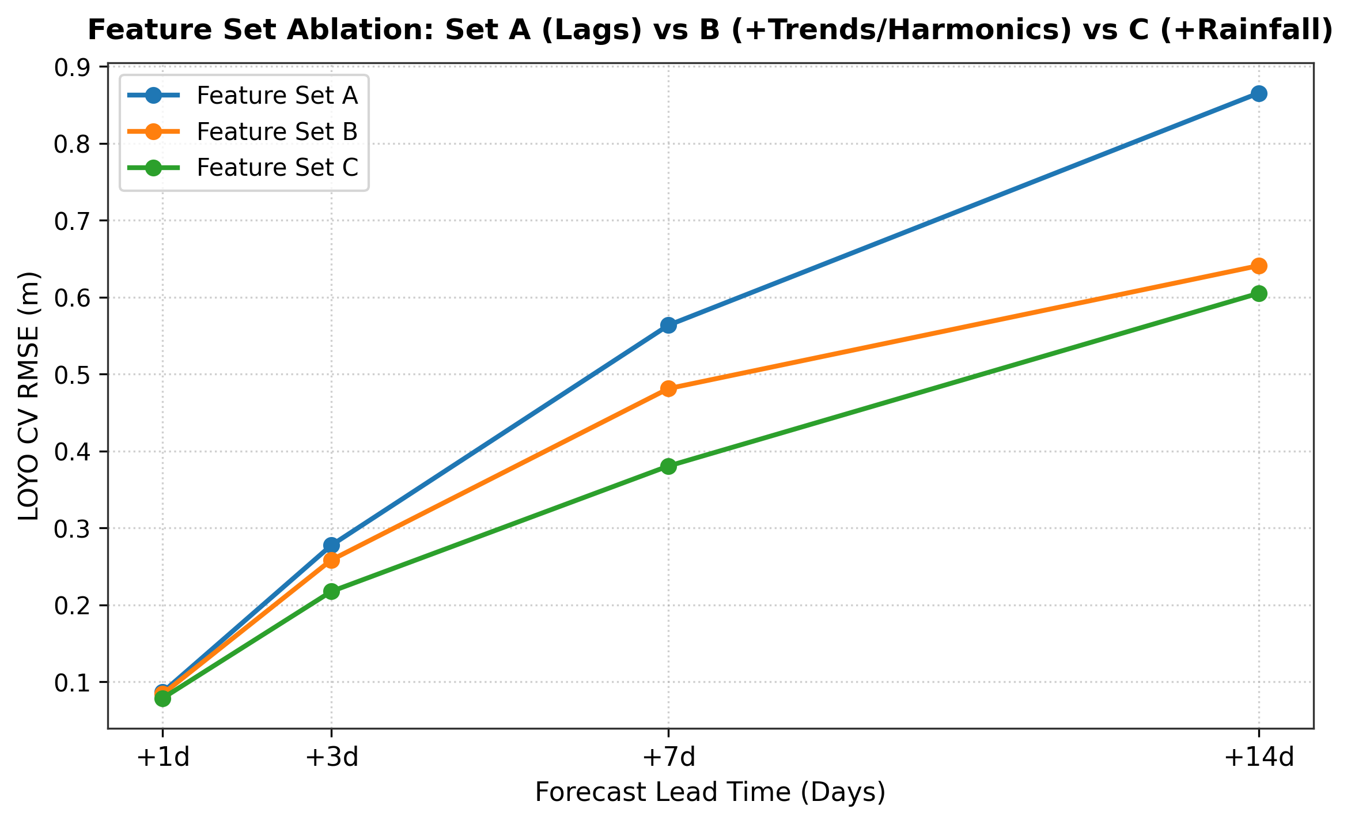
AquaGuard_Final_Release/software/backend/model_1_flood/outputs/figures/F17_feature_ablation_a_b_c.png
