Srabon-bot/Aquaguard/AquaGuard_Final_Release/software/backend/model_1_flood/outputs/figures/F18_models_metrics_heatmap.png

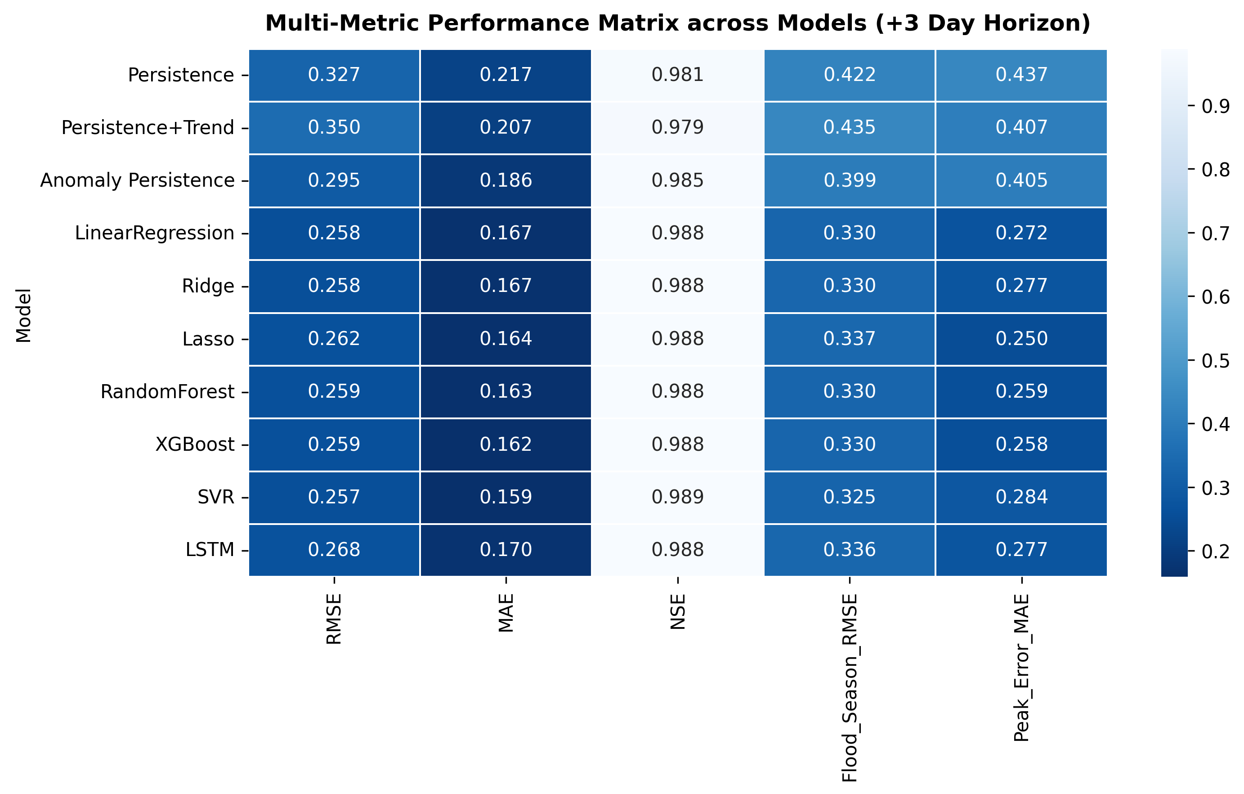
AquaGuard_Final_Release/software/backend/model_1_flood/outputs/figures/F18_models_metrics_heatmap.png
