Srabon-bot/Aquaguard/AquaGuard_Final_Release/software/backend/model_1_flood/outputs/figures/F20_scatter_1to1_by_horizon.png

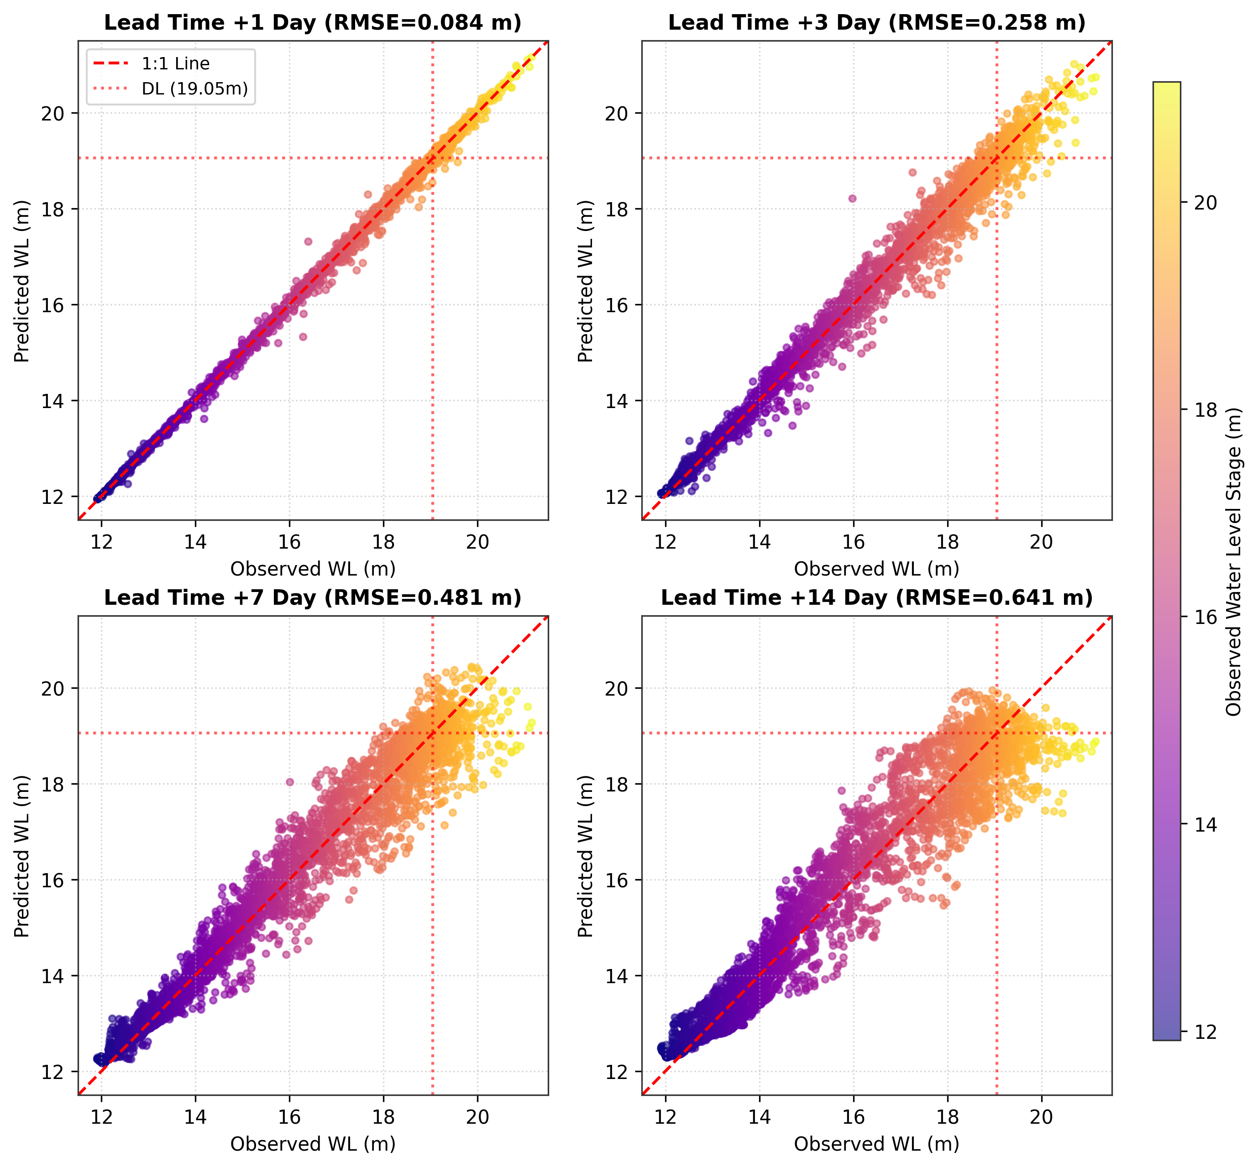
AquaGuard_Final_Release/software/backend/model_1_flood/outputs/figures/F20_scatter_1to1_by_horizon.png
