Srabon-bot/Aquaguard/AquaGuard_Final_Release/software/backend/model_1_flood/outputs/figures/F21_residual_diagnostics.png

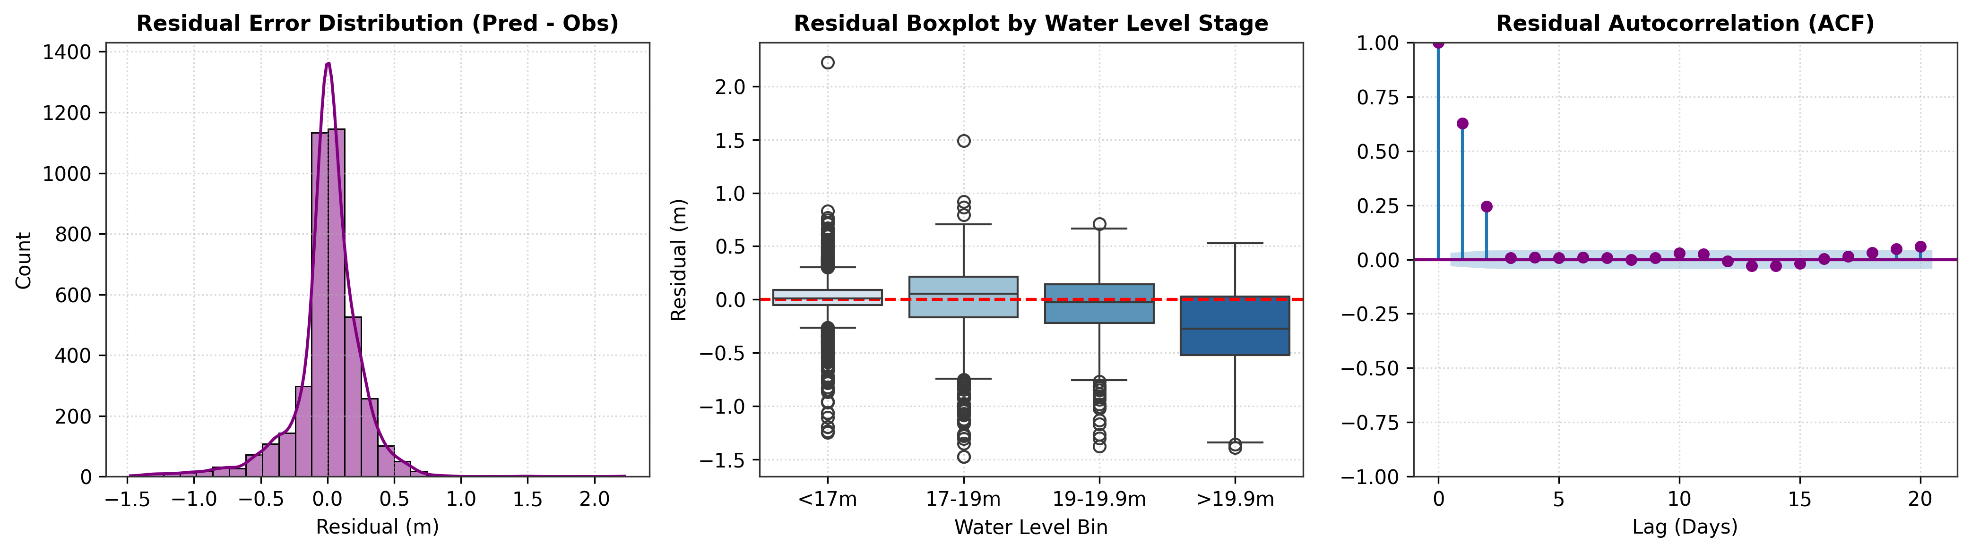
AquaGuard_Final_Release/software/backend/model_1_flood/outputs/figures/F21_residual_diagnostics.png
