Srabon-bot/Aquaguard/AquaGuard_Final_Release/software/backend/model_1_flood/outputs/figures/F23_event_timeline_confusion_matrix.png

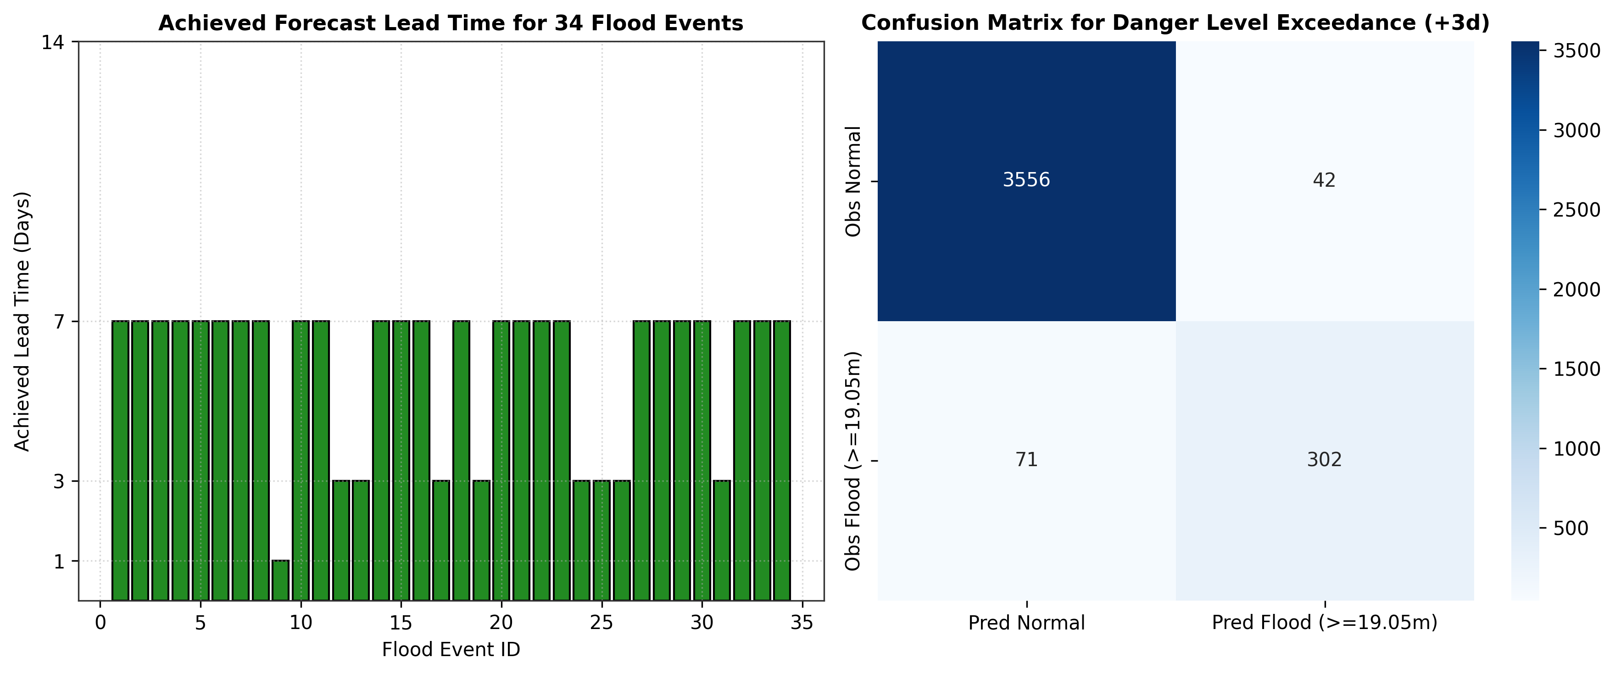
AquaGuard_Final_Release/software/backend/model_1_flood/outputs/figures/F23_event_timeline_confusion_matrix.png
