Srabon-bot/Aquaguard/AquaGuard_Final_Release/software/backend/model_1_flood/outputs/figures/report_extra/FigD_warning_threshold_hydrograph.png

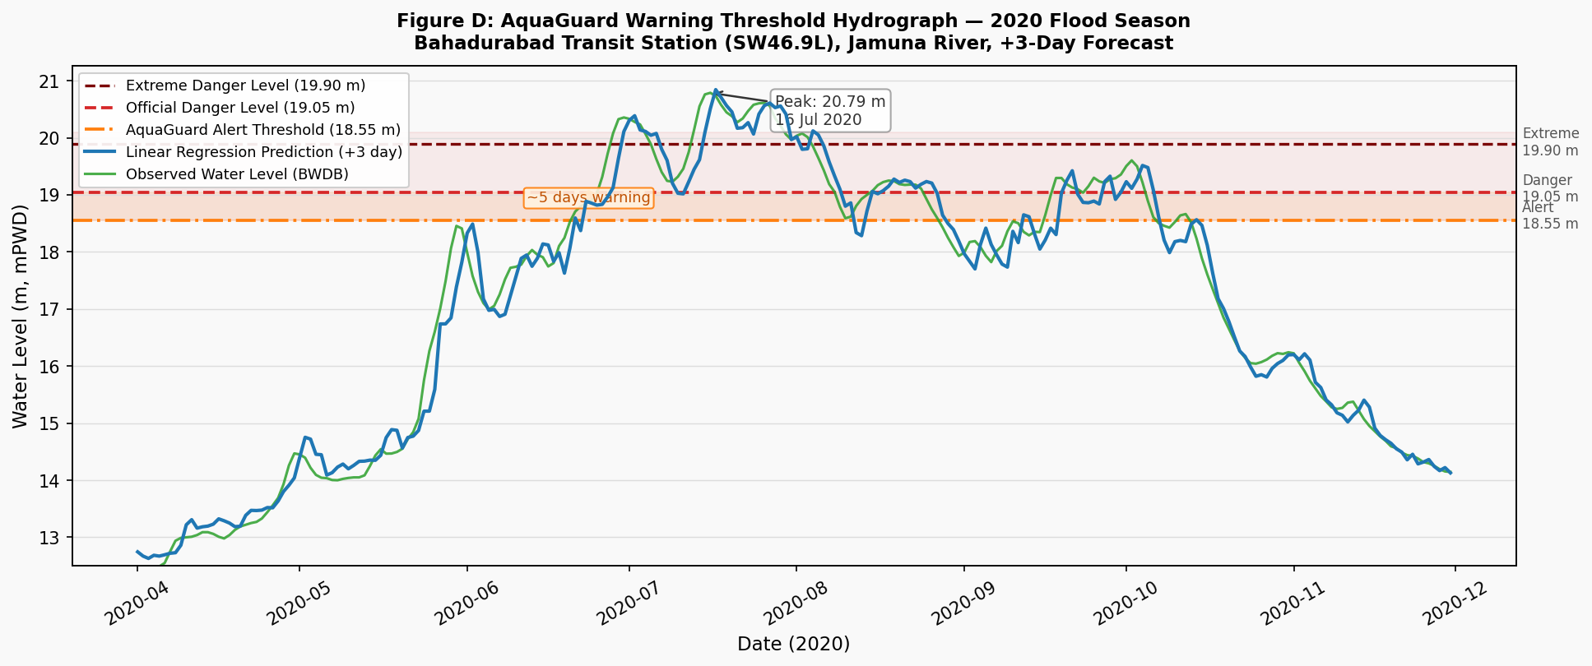
AquaGuard_Final_Release/software/backend/model_1_flood/outputs/figures/report_extra/FigD_warning_threshold_hydrograph.png
