Srabon-bot/Aquaguard/AquaGuard_Final_Release/software/backend/model_1_flood/outputs/figures/report_extra/FigG_model1_pipeline_diagram.png

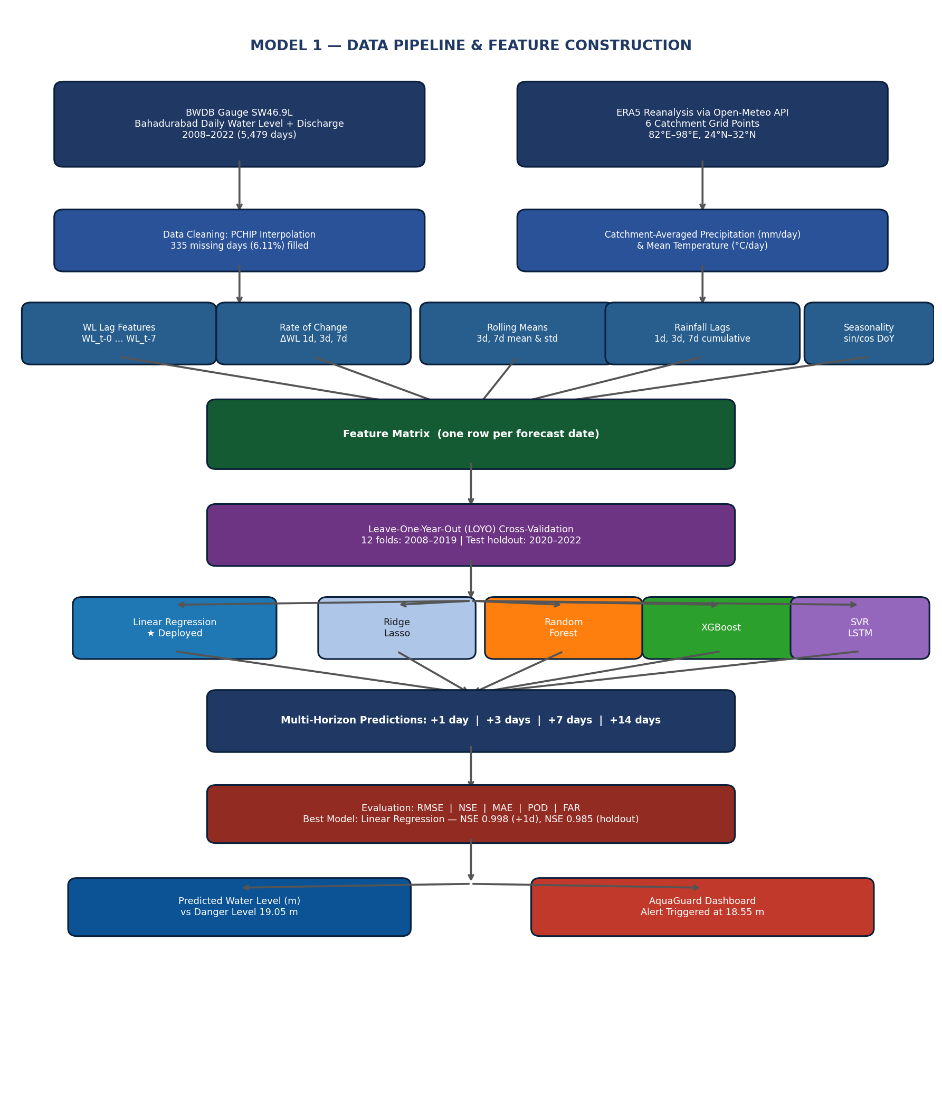
AquaGuard_Final_Release/software/backend/model_1_flood/outputs/figures/report_extra/FigG_model1_pipeline_diagram.png
