Srabon-bot/Aquaguard/AquaGuard_Final_Release/software/backend/model_1_flood/outputs/figures/report_extra/FigH_data_sources_diagram.png

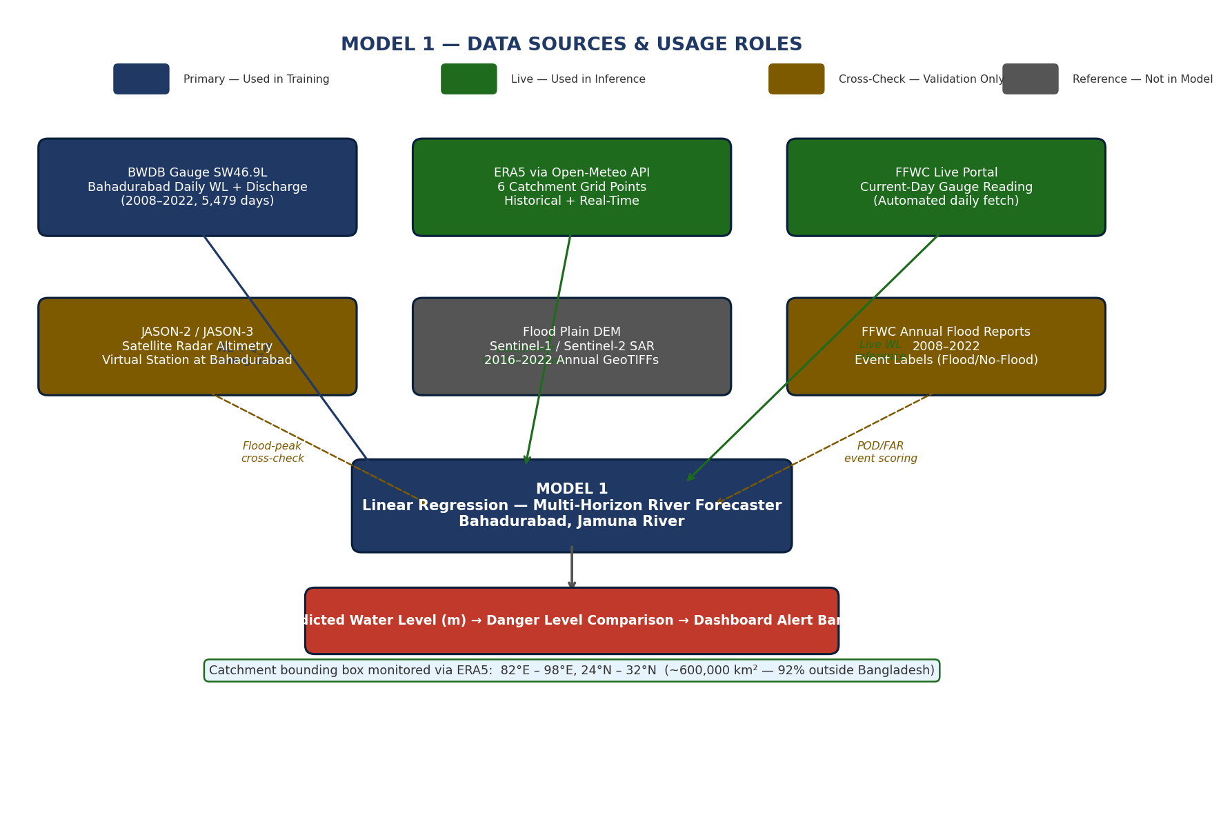
AquaGuard_Final_Release/software/backend/model_1_flood/outputs/figures/report_extra/FigH_data_sources_diagram.png
