Srabon-bot/Aquaguard/AquaGuard_Final_Release/software/backend/model_2/outputs/figures/scatter_actual_vs_predicted.png

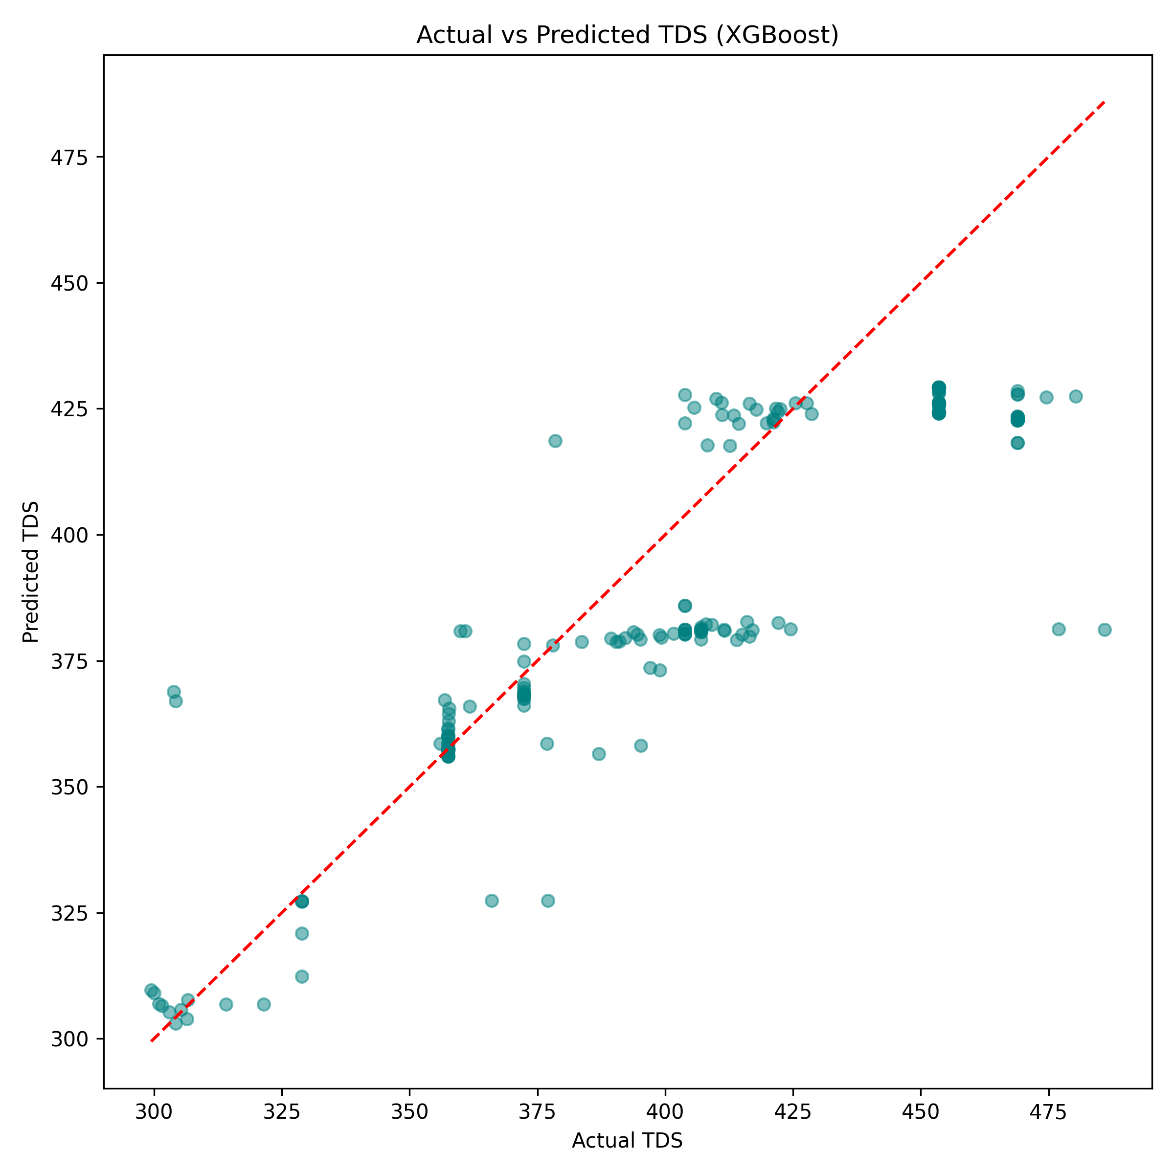
AquaGuard_Final_Release/software/backend/model_2/outputs/figures/scatter_actual_vs_predicted.png
