Srabon-bot/Aquaguard/hardware/esp32_board_photo.jpg

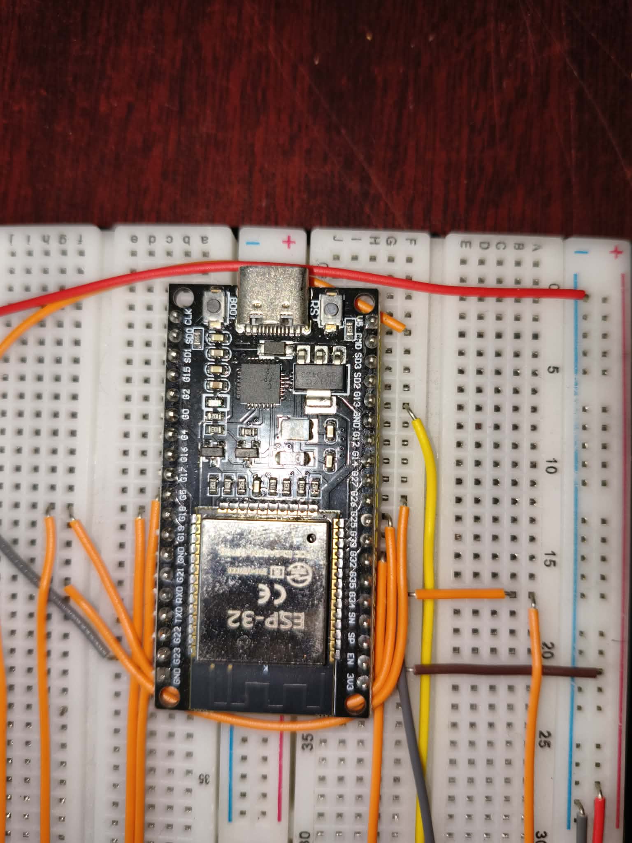
hardware/esp32_board_photo.jpg
