Srabon-bot/Aquaguard/reports/project-report/assets/architecture_diagram.png

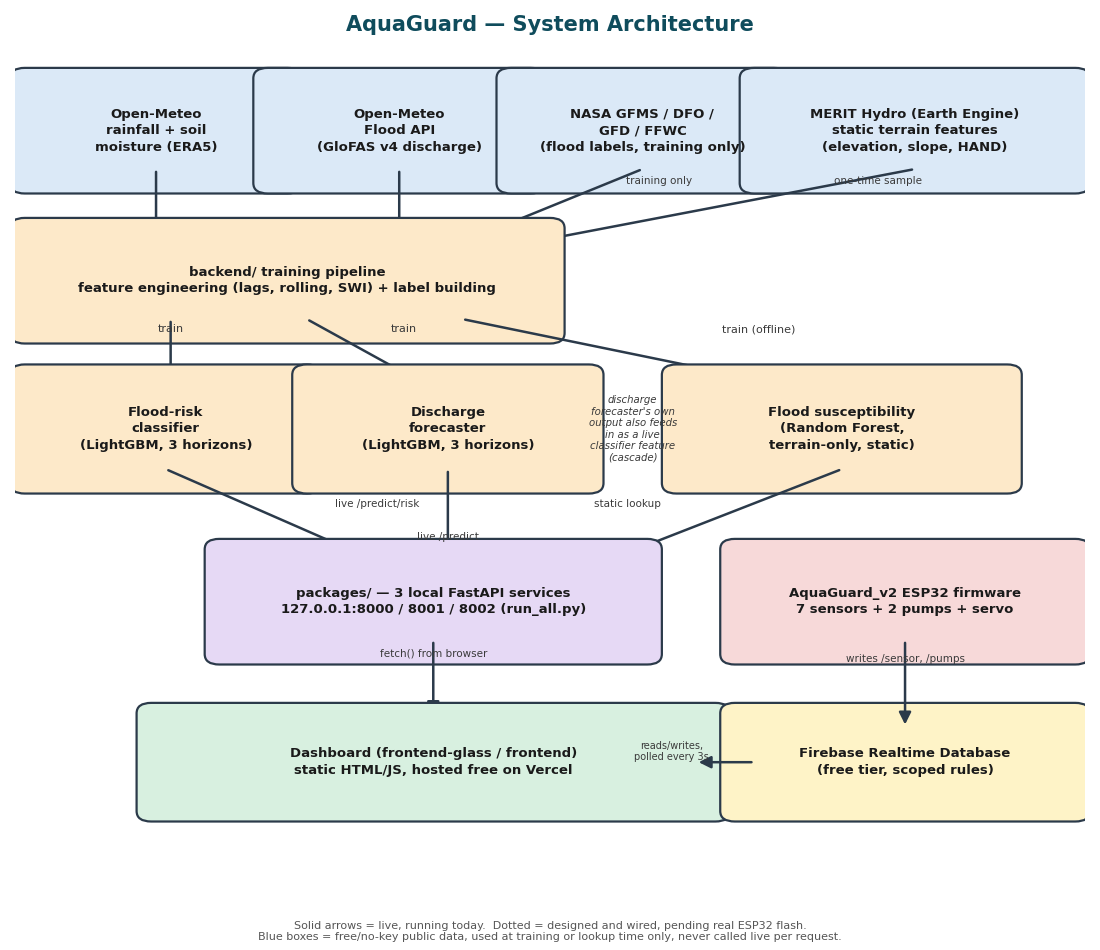
reports/project-report/assets/architecture_diagram.png
