Srabon-bot/Aquaguard/AquaGuard_Final_Release/software/frontend/ph-calibration.html

🧪

# pH Calibration

Two-point calibration, done from any browser — no re-flashing the ESP32

← Back to dashboard

This page talks directly to your Firebase Realtime Database — the same one the ESP32 firmware (hardware/AquaShield_v2/AquaShield_v2.ino) uses. Already wired to the AquaSheild project's database (FIREBASE_BASE_URL in ph-calibration.js) — nothing to configure here, this will show live data as soon as the ESP32 is flashed and running.

## How this works

Fixed to two kitchen reference solutions — always the same two, so there's nothing to type in here:

### 🧪 Acid point

Plain white vinegar, 5% acidity — reference pH 2.4.

### 🧂 Base point

~1 tsp baking soda dissolved in 1 cup water — reference pH 8.3.

1. Rinse the probe, dip it in the vinegar. Watch the live voltage below settle (stop drifting), then click Capture acid point.
2. Rinse the probe, dip it in the baking soda solution. Wait for it to settle, then click Capture base point.
3. Click Save calibration — this writes to the ESP32's flash and takes effect immediately, no reboot needed.

## Live status

Connecting…

## Actions

🧪 Capture acid point (vinegar) 🧂 Capture base point (baking soda)

💾 Save calibration 🗑 Clear saved calibration

AquaShield — pH calibration page. Firmware: hardware/rebuild/07_full_reintegration/.
