Srabon-bot/Aquaguard/AquaGuard_Final_Release/software/backend/model_1_flood/outputs/figures/F12_hyperparameter_validation_curves.pdf

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

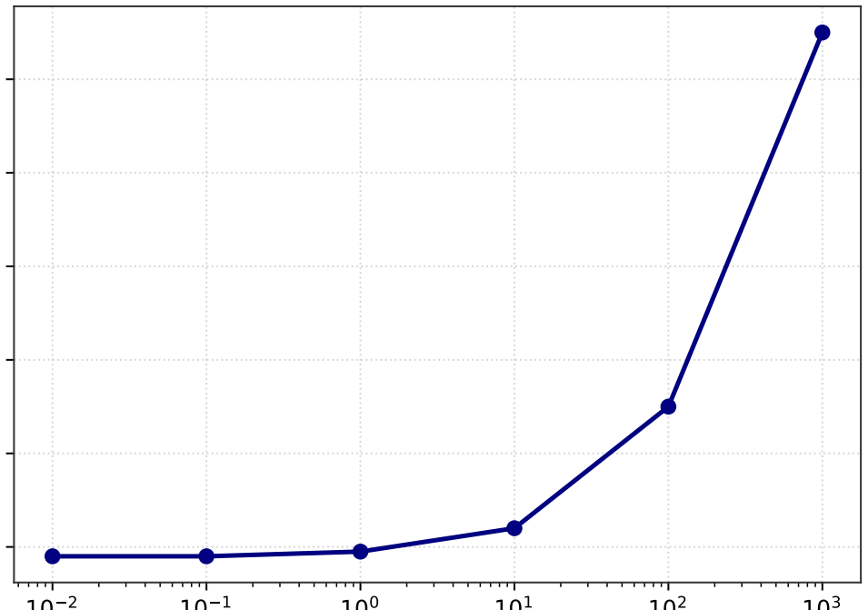
[picture p44: figure]
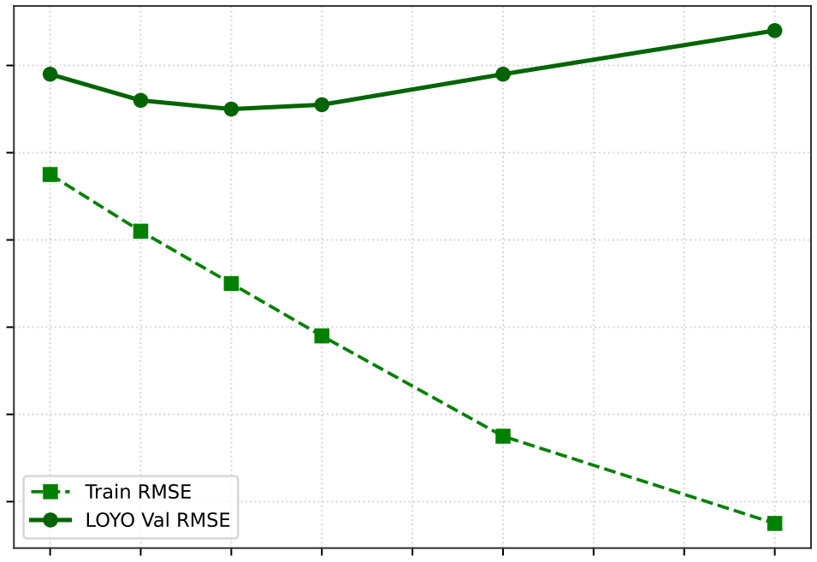
[picture p45: figure]
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
