Srabon-bot/Aquaguard/AquaGuard_Final_Release/software/backend/model_1_flood/outputs/tables/T3_loyo_results_all_horizons.csv

Model | Horizon | Feature_Set | RMSE | MAE | Bias | NSE | Flood_Season_RMSE | Peak_Error_MAE | POD_HitRate | FAR | RMSE_lt_17m | RMSE_17_19m | RMSE_19_19.9m | RMSE_gt_19.9m
Persistence | 1 | B | 0.1265024297900457 | 0.07974805520702634 | -0.0009726474278544536 | 0.9972290208876009 | 0.16136488040797511 | 0.05121428571428562 | 0.928 | 0.06702412868632708 | 0.09728762421285299 | 0.16931219677945375 | 0.16408450335855668 | 0.2300556454425755
Persistence+Trend | 1 | B | 0.09527491227183842 | 0.054565119196988754 | 0.00010087829360100446 | 0.9984282168357808 | 0.11785365994827951 | 0.12342857142857129 | 0.9413333333333334 | 0.03814713896457766 | 0.07459709279056914 | 0.1290206154776864 | 0.12119533444365348 | 0.13629600140869846
Anomaly Persistence | 1 | B | 0.11626655673449032 | 0.0713238568875708 | -0.0006571362305615793 | 0.9976593033189508 | 0.15293606940255516 | 0.06176975108225185 | 0.92 | 0.0547945205479452 | 0.08649753237971222 | 0.15769673277724247 | 0.15561841217219172 | 0.22238024462573336
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
