Srabon-bot/Aquaguard/AquaGuard_Final_Release/software/backend/model_1_flood/outputs/tables/T6_final_holdout_results.csv

Model | Horizon | Holdout_Period | RMSE | MAE | Bias | NSE | Baseline_RMSE | Skill_vs_Baseline
LinearRegression | +3 days | 2020–2022 | 0.30820908607522246 | 0.20354609366602114 | 0.016403018935578658 | 0.9850710499220582 | 0.39107964424507774 | 0.21190199845308955
