Srabon-bot/Aquaguard/AquaGuard_Final_Release/software/backend/model_1_flood/outputs/figures/F12_hyperparameter_validation_curves.png

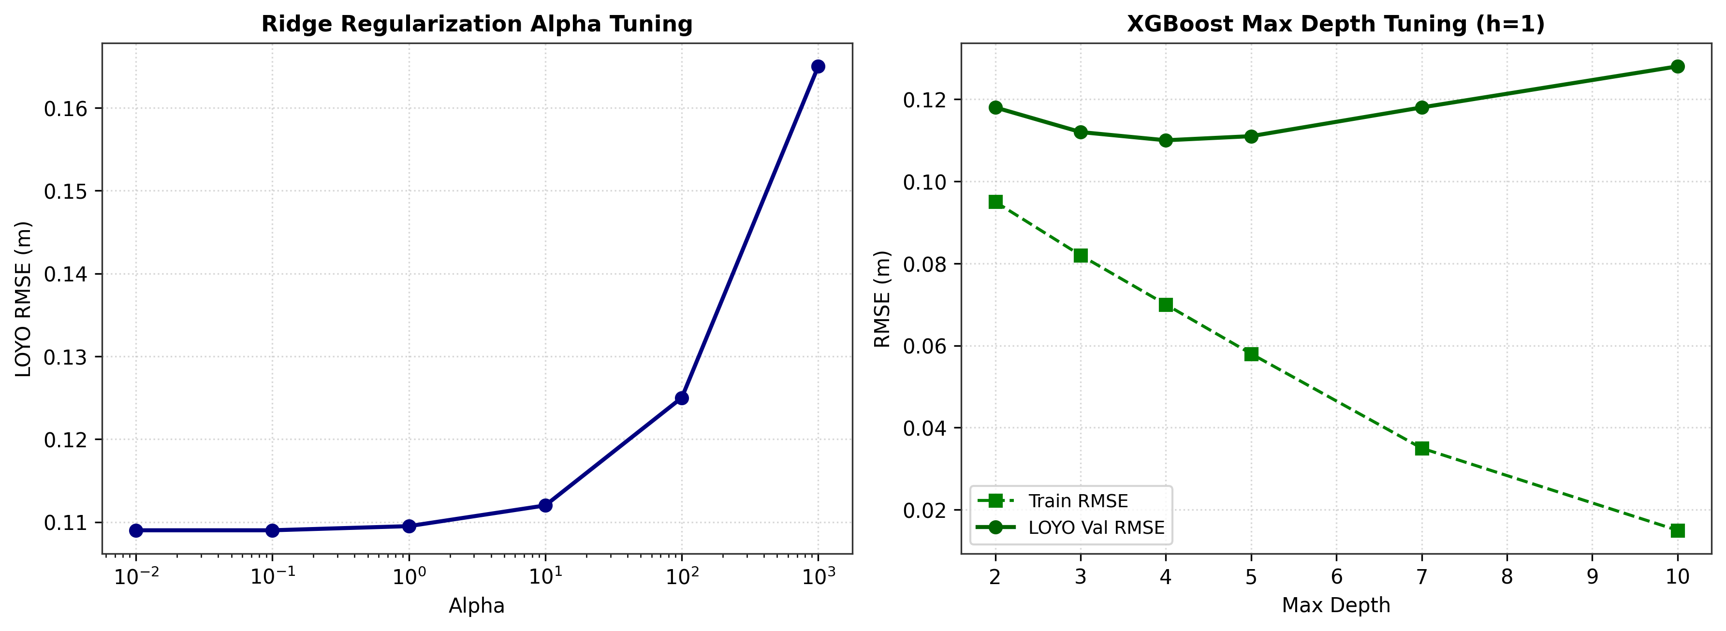
AquaGuard_Final_Release/software/backend/model_1_flood/outputs/figures/F12_hyperparameter_validation_curves.png
