Srabon-bot/Aquaguard/AquaGuard_Final_Release/software/backend/model_1_flood/outputs/figures/F05_flood_events_timeline_histogram.pdf

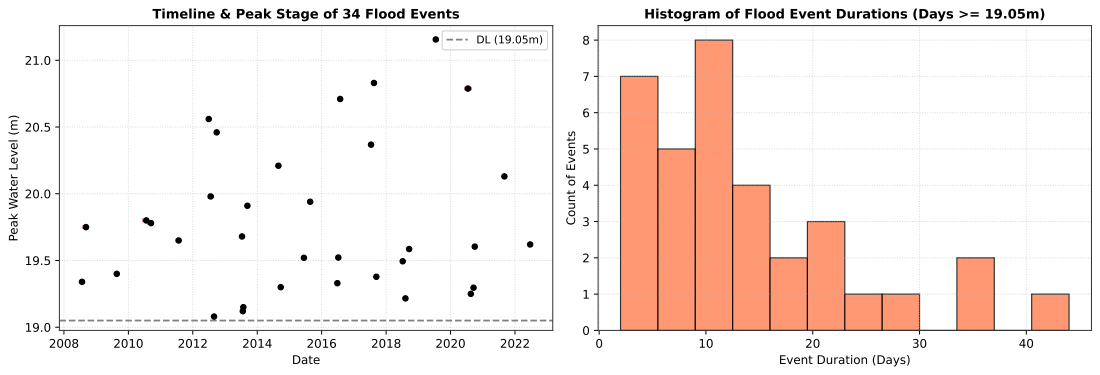
[picture p47: page 1]
Date

Timeline & Peak Stage of 34 Flood Events

Histogram of Flood Event Durations (Days >= 19.05m)

Peak Water Level (m)

Count of Events

Event Duration (Days)
