Srabon-bot/Aquaguard/new_models/new_approach/model_1_flood/outputs/figures/report_extra/FigD_warning_threshold_hydrograph.pdf

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

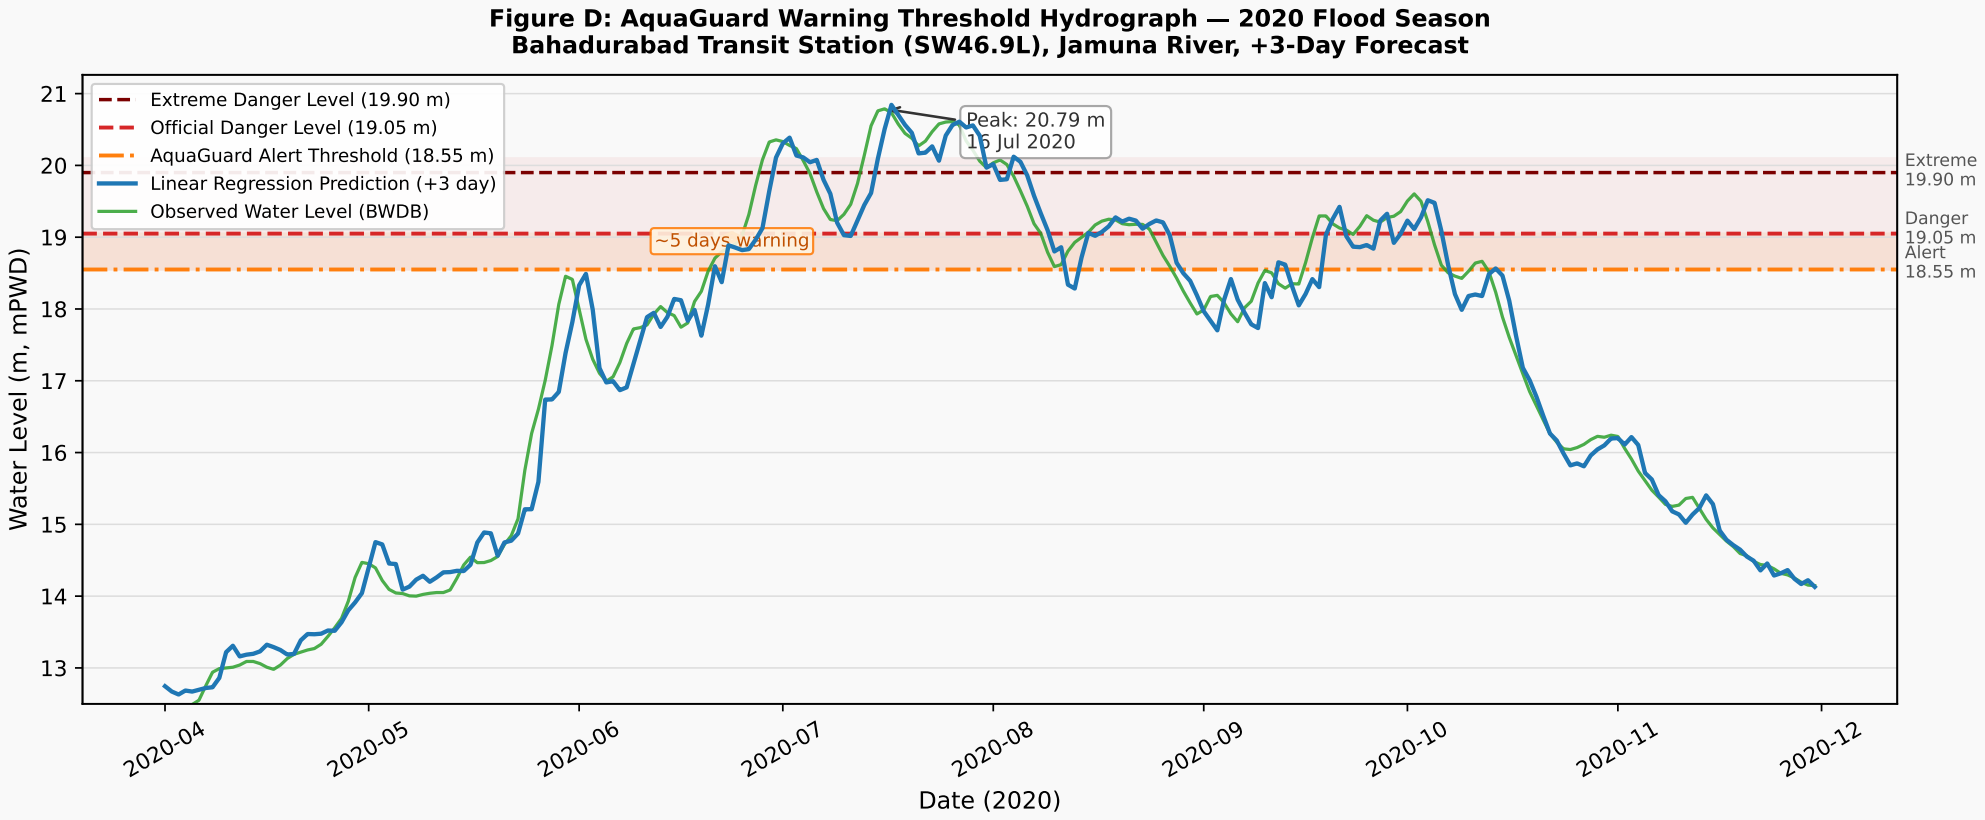
[picture p49: page 1]
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
