Srabon-bot/Aquaguard/new_models/new_approach/model_1_flood/outputs/figures/report_extra/FigG_model1_pipeline_diagram.pdf

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

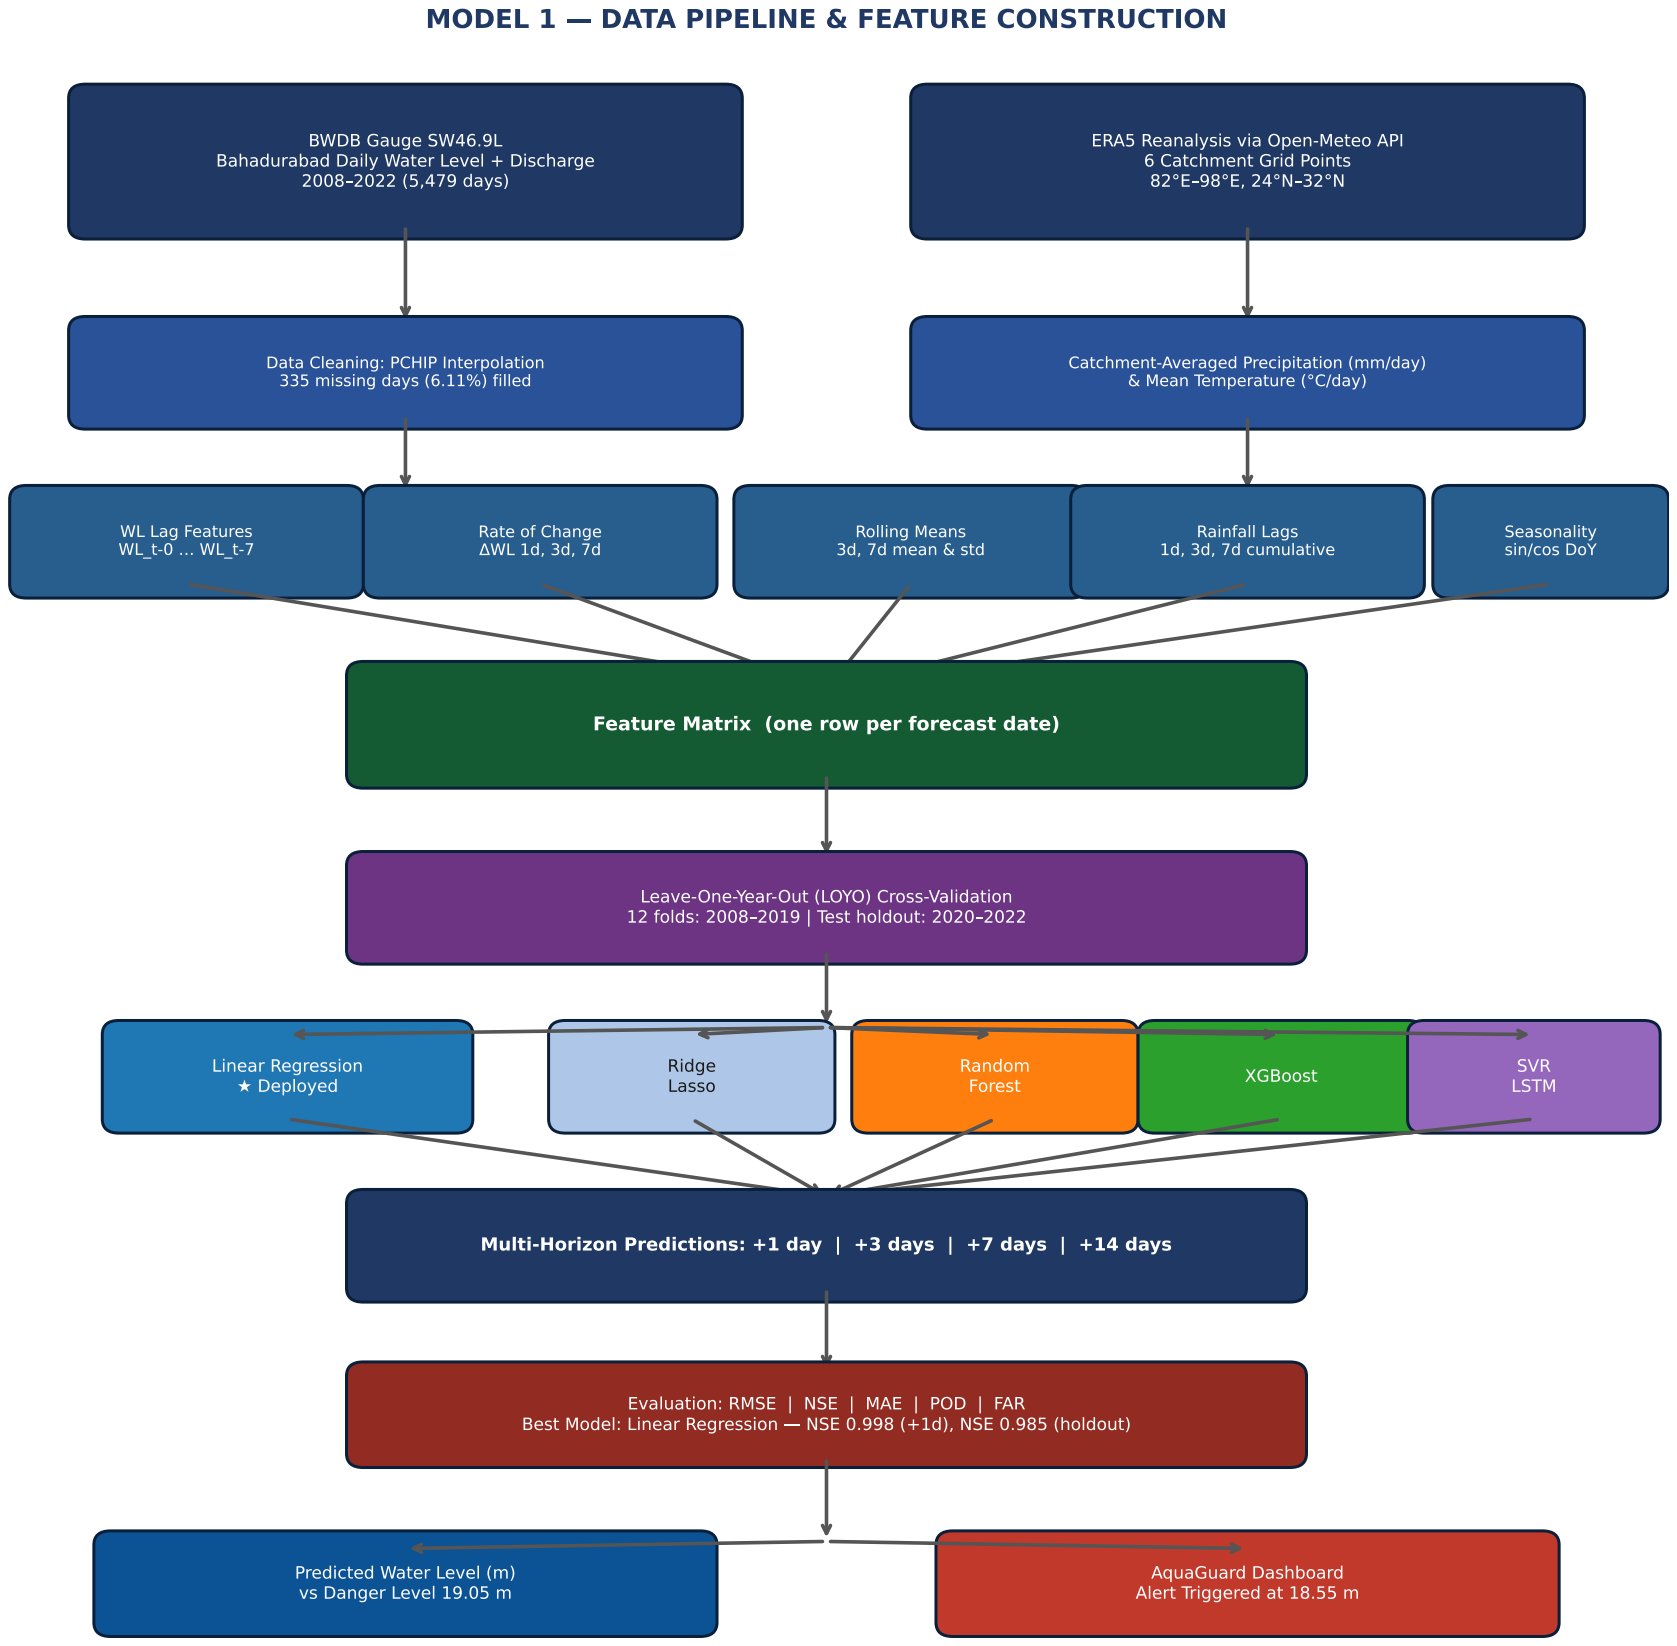
[picture p50: page 1]
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
