Srabon-bot/Aquaguard/AquaGuard_Final_Release/software/backend/model_1_flood/outputs/figures/F24_final_holdout_performance_2020_2022.pdf

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

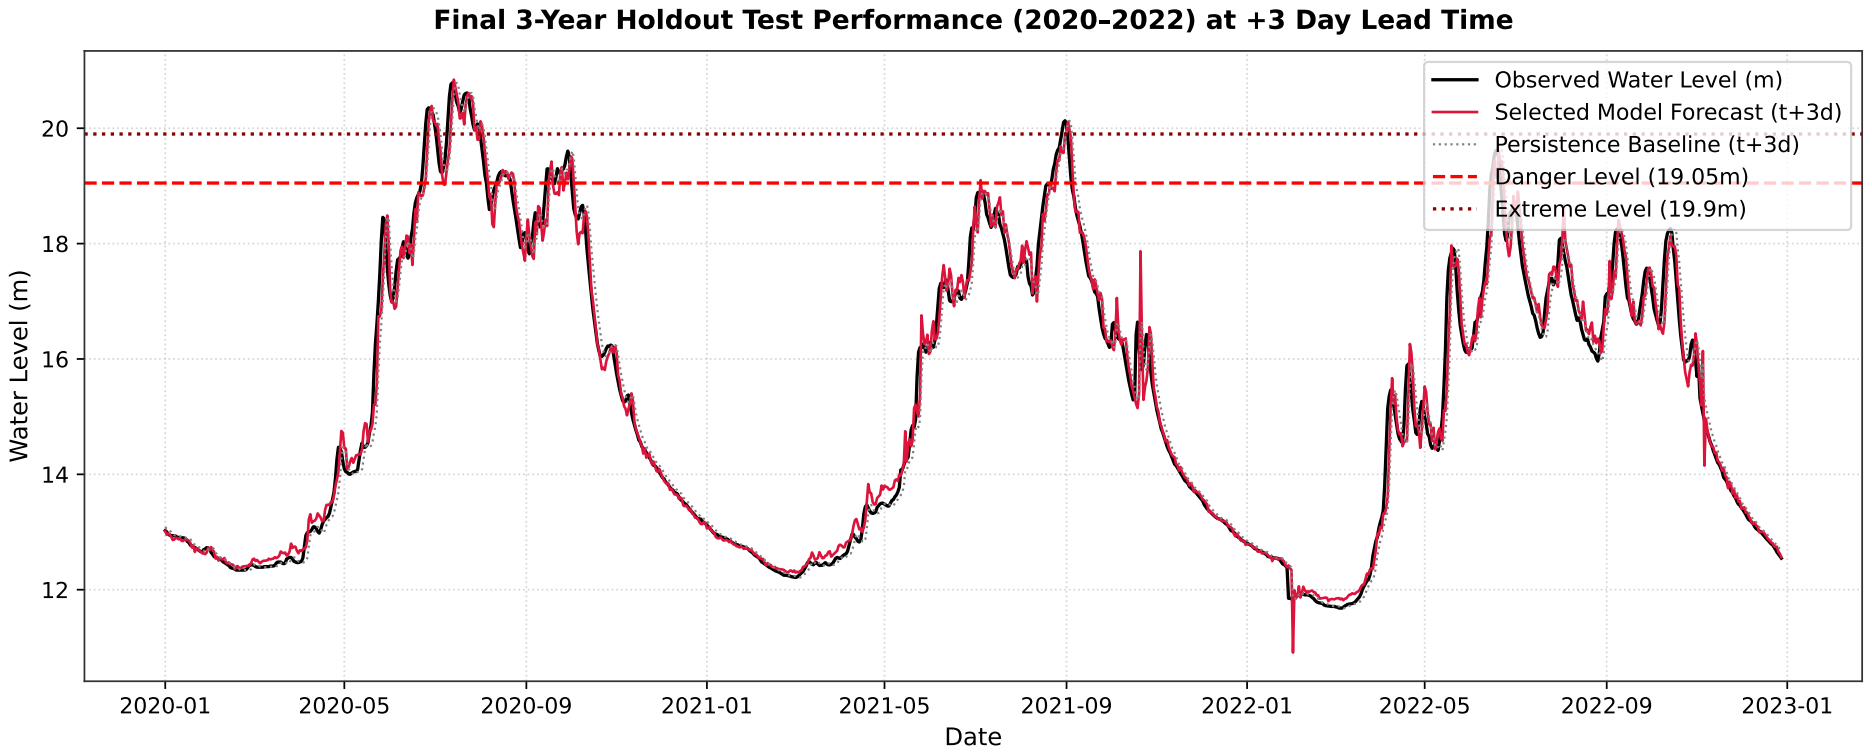
[picture p51: page 1]
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
