Srabon-bot/Aquaguard/AquaGuard_Final_Release/software/backend/model_1_flood/outputs/figures/F04_seasonal_cycle_and_peaks.pdf

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

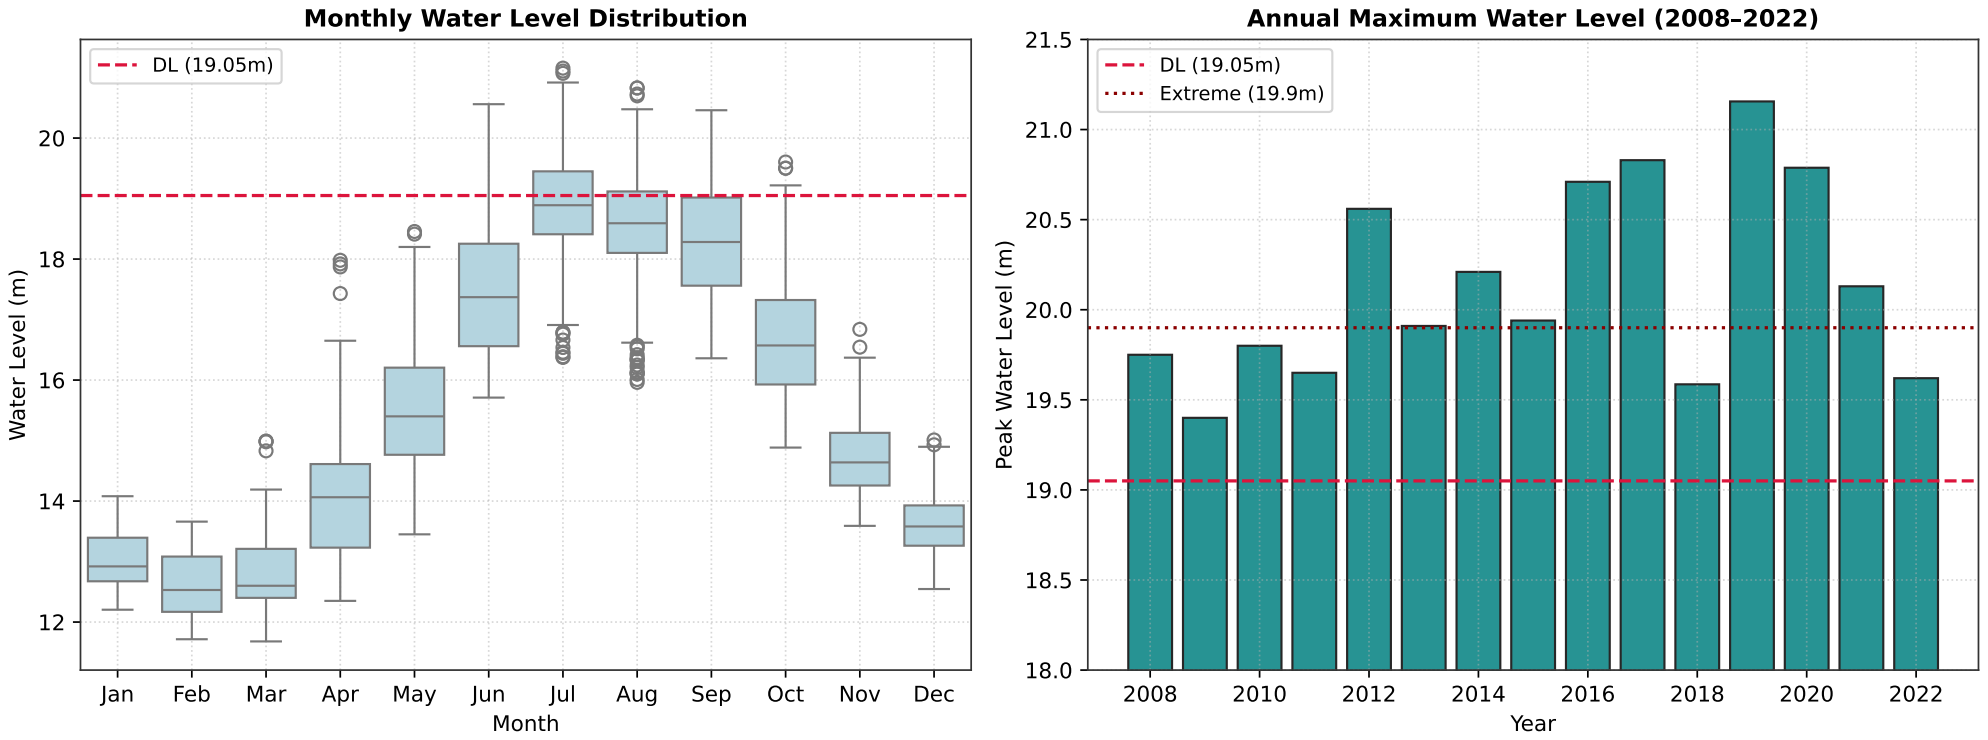
[picture p54: page 1]
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
