Srabon-bot/Aquaguard/AquaGuard_Final_Release/software/backend/model_1_flood/outputs/figures/F07_rating_curve_wl_vs_q.pdf

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

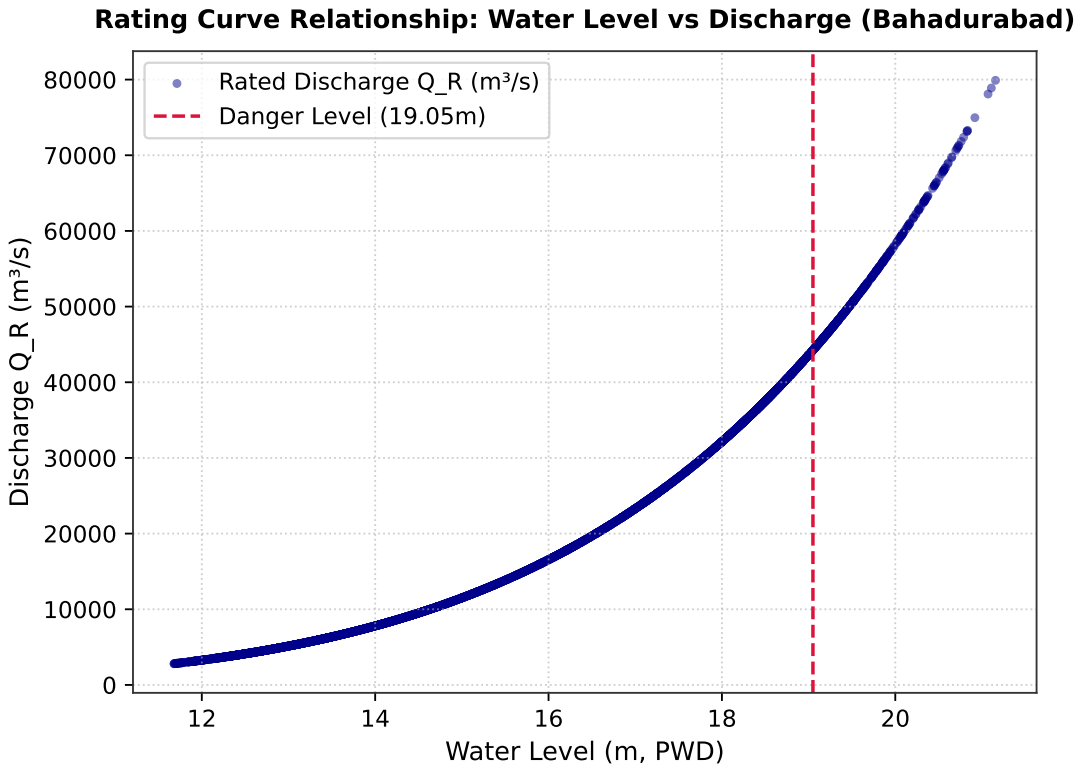
[picture p56: page 1]
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
