Srabon-bot/Aquaguard/AquaGuard_Final_Release/software/backend/model_1_flood/outputs/figures/F08_catchment_rainfall_vs_wl.pdf

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

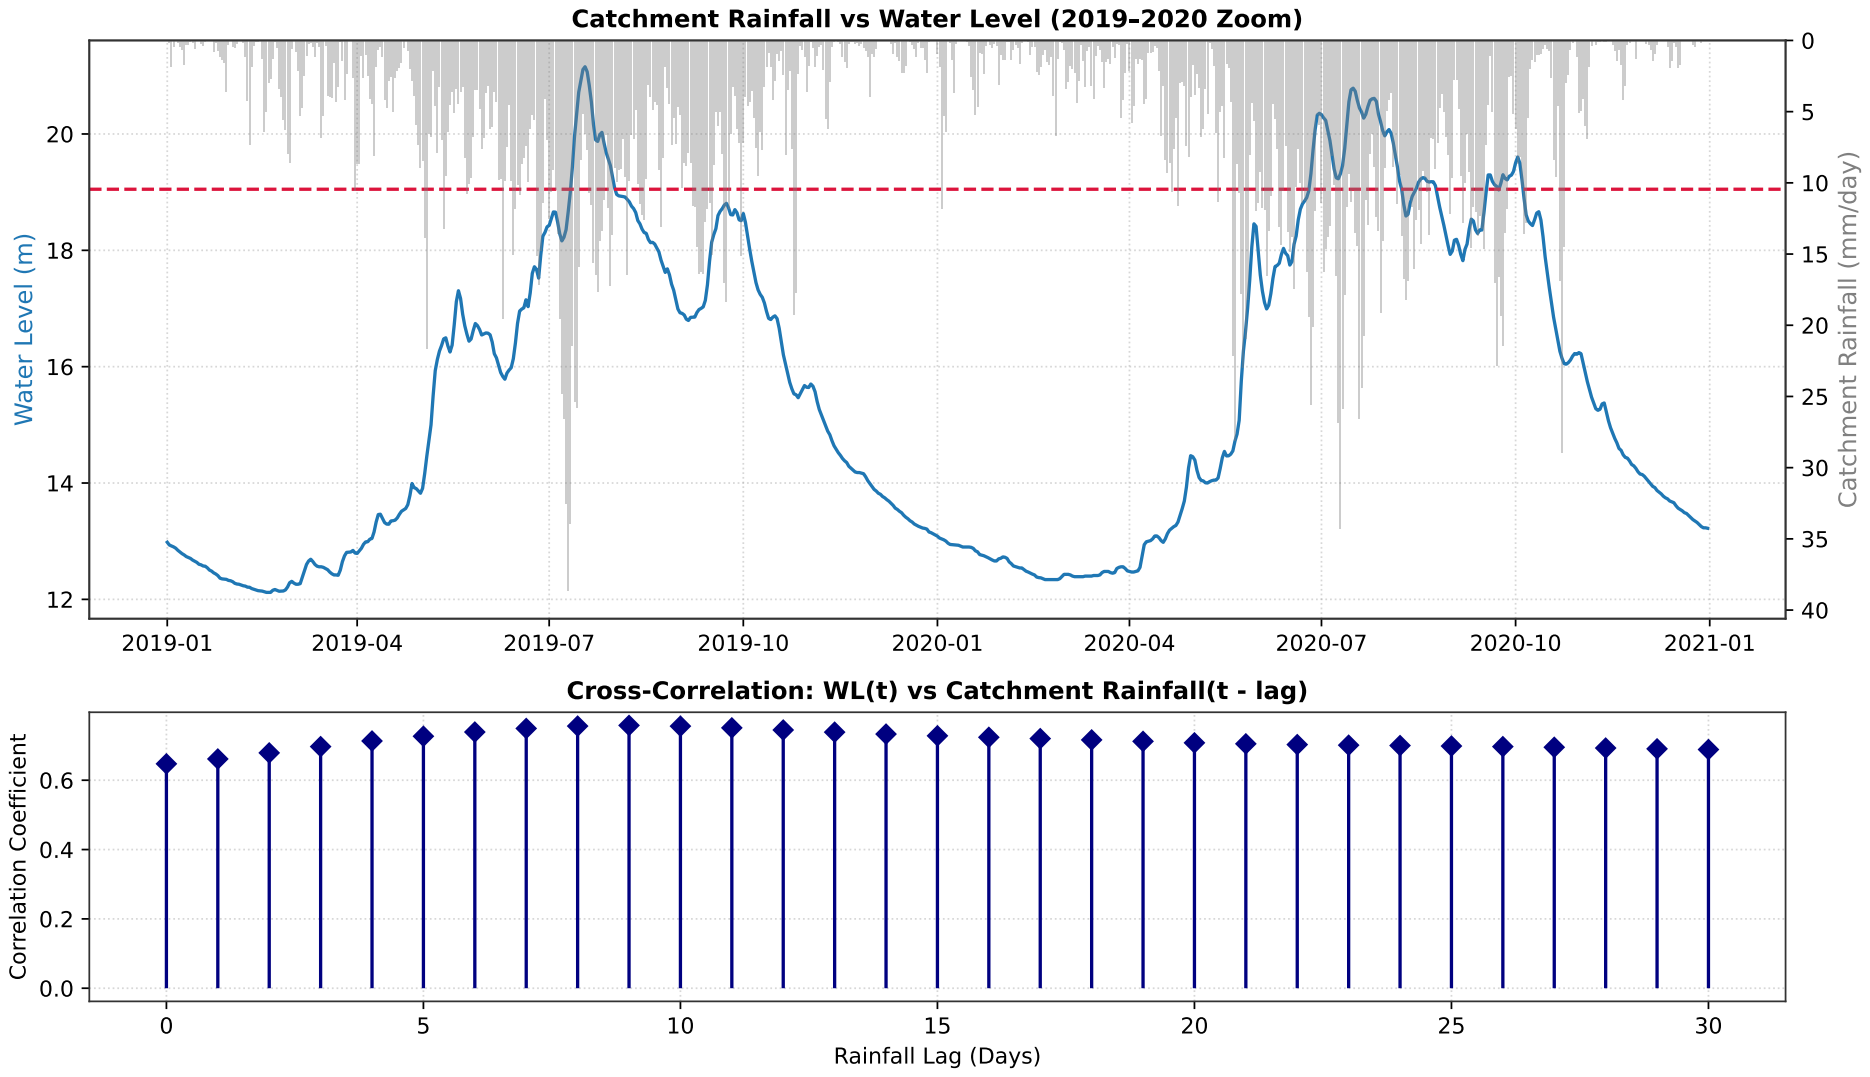
[picture p57: page 1]
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
