Srabon-bot/Aquaguard/AquaGuard_Final_Release/software/backend/model_1_flood/outputs/figures/F14_rmse_vs_lead_time_all_models.pdf

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

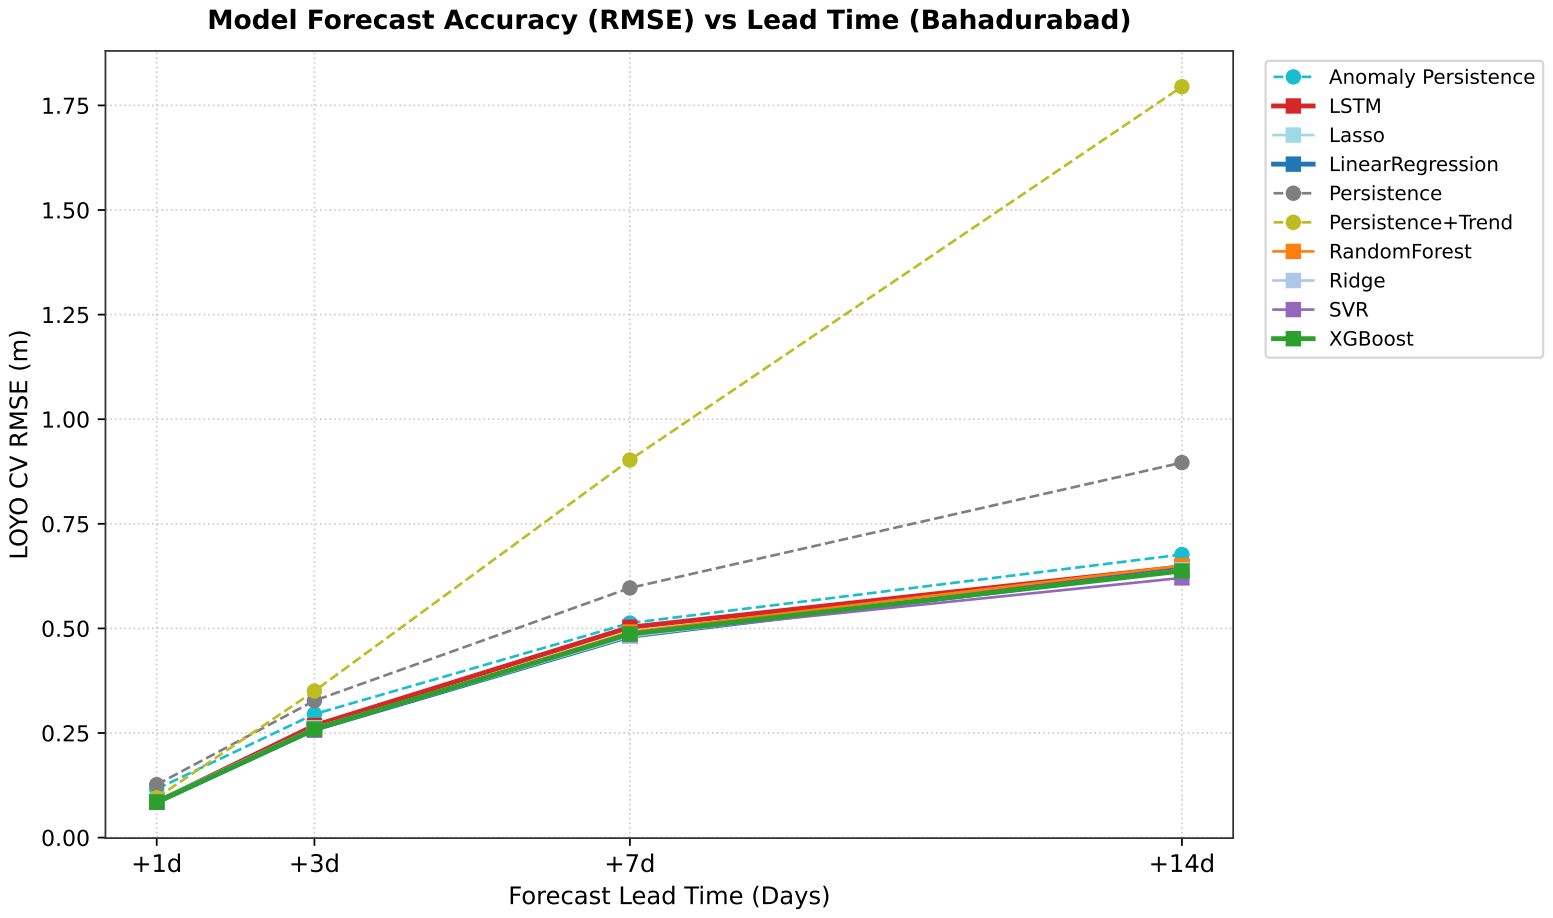
[picture p58: page 1]
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
