Srabon-bot/Aquaguard/(commit log)

2026-08-14 SECURITY: redact hardcoded WiFi/Firebase credentials from reference sketch
    hardware/original_reference/AquaGuard_full_original.ino had a real WiFi
    password and a Firebase legacy database secret hardcoded (from an old,
    now-retired Firebase project). Replaced with placeholders; see
    hardware/FIREBASE_SETUP.md for filling in real values locally, never
    committed.
    [AquaGuard_full_original.ino]
2026-08-14 Organize repo for public GitHub: one-button pipeline UI, Firebase setup guide, portable model package, project manual, PDF manuals
    - frontend/frontend-glass: single 'Run full analysis' button firing all 3
    model calls together (mirrored to both).
    - hardware/FIREBASE_SETUP.md: step-by-step guide for setting up a new
    Firebase project (account creation is a user-only step).
    - packages/: consolidated requirements.txt, run_all.py launcher,
    start_all.bat/.sh, and SETUP_MANUAL.md so all 3 model services can be set
    up and run together from one copy of packages/.
    - README.md: top-level project manual (didn't exist before).
    - manuals/: PDF versions of the above 3 docs (scripts/md_to_pdf.py, a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
2026-08-14 Add Firebase-driven pH calibration: firmware, dashboard page, manual
    - hardware/rebuild/07_full_reintegration/AquaGuard_v2.ino: first real merge
    of all rebuild steps (WiFi/Firebase/sensors/pumps/servo), with the
    thermistor formula fix and calibrated-pH formula actually applied (not
    just noted), plus a new non-blocking pH calibration state machine
    triggered over Firebase instead of Serial. Fixed to vinegar (pH 2.4) /
    baking soda (pH 8.3) per user's stated standard references. Not yet
    flash-tested on real hardware.
    - frontend{,-glass}/ph-calibration.html + .js: new dashboard page, linked
    from the main header, live voltage + status display, capture/save/clear
    buttons, plain Fire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
    [AquaGuard_v2.ino]
2026-08-14 Add pump check-valve circuit diagram
    hardware/PUMP_CHECK_VALVE_DIAGRAM.pdf: one-page diagram showing where to
    install a check valve on each pump's discharge line (right at the pump's
    own outlet, one per pump) and the spring-poppet mechanism that stops the
    siphon when the pump turns off. Generated by
    hardware/generate_pump_valve_diagram.py (matplotlib -> PDF directly),
    verified by rendering to PNG and inspecting -- caught and fixed a text
    overlap and a right-edge clipping bug in the first draft before finalizing.
2026-08-14 Add ready-to-flash ESP32 firmware folder + hardware connection manual
    - hardware/AquaGuard_v2/: one consolidated folder for hardware bring-up --
    AquaGuard_v2.ino (final combined firmware, real Firebase host pre-filled,
    WiFi/database-secret left as placeholders), plus copies of all 6
    per-device standalone test sketches (01_ph_sensor through 06_servo) to
    test one device at a time as it's physically wired, before uploading the
    combined firmware last.
    - hardware/rebuild/06_servo/: new standalone servo test sketch + README
    (closes a gap HARDWARE_LOG.md has tracked all session as 'not yet
    built') -- 0-180-0 degree sweep test, same no-WiFi/no-Firebase pattern
    as every other rebuild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
2026-08-14 Wire dashboard to real Firebase; add analytics page
    - app.js (both frontends): sensor tiles + pump control now read/write real
    Firebase (/sensor/*, /pumps/*) instead of demo/simulated data. Pump clicks
    and the water-cycle timer both write real state; a poller reconciles the
    UI to whatever Firebase actually reports every few seconds (so it stays
    correct even if a write drops, or state changes from elsewhere). pH tile
    shows 'NOT CALIBRATED' honestly instead of a fabricated number when the
    probe hasn't been calibrated yet.
    - ph-calibration.js (both frontends): FIREBASE_BASE_URL filled in with the
    real AquaSheild project URL -- fully live now, no more placeholder.
    - New analytics.h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
2026-08-14 Fix real WCAG contrast failures in frontend-glass color palette
    User reported text was hard to read against the gradient background.
    Researched glassmorphism accessibility guidance (semi-opaque fills over
    raw transparency, don't rely on blur for separation), then measured every
    text/background pair programmatically (alpha-blend math against every
    stop of both gradients) rather than guessing -- found real, confirmed
    failures, not just a vague impression:
    - text-muted on glass-fill: 3.41:1 (needs 4.5)
    - status chips (same-hue text-on-tint pattern): 1.9-3.0:1 across all 4
    statuses, both themes -- the worst offender, these appear everywhere
    (risk badges, sensor chips, pump status, alert bann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
2026-08-14 Fix root cause of remaining unreadable text; add iOS-style glass depth
    Root cause of the user's continued 'still hard to read' report: 3 whole
    sections (Sensor readings, Pump control, Regional forecast models) plus
    the topbar and page footer had NO background at all -- bare .panel with
    no .neu-raised/.neu-flat modifier class, or explicitly
    background:transparent -- sitting directly on the raw gradient with zero
    backing. No amount of retuning --text-muted (last commit) could fix that,
    since there was no glass-fill for the color math to apply to in the first
    place. Confirmed by grepping every <section class="panel"> in the HTML
    against its CSS, not just staring at a screenshot.
    Fixed: added n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
2026-08-14 Add in-depth whole-project report (PDF) + fix md_to_pdf.py image bugs
    New reports/project-report/: PROJECT_REPORT.md (source), a matplotlib
    architecture diagram, and the built 8-page AquaGuard_Project_Report.pdf.
    Every metric quoted in it comes directly from each model's own
    metrics.json (classifier, discharge forecaster, susceptibility), and
    the hardware status table matches hardware/HARDWARE_LOG.md's actual
    current state, not a rounded-up summary. Synced to
    manuals/6_Project_Report.pdf and referenced from README.md's
    technical deep-dive section.
    Fixed three real bugs in scripts/md_to_pdf.py found while building the
    diagram page, each confirmed by isolated bisection before fixing:
    - pymupd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
2026-09-27 update 27/9/26
    [65 Years of Weather Data Bangladesh (1948 - 2013).csv, per_station_susceptibility.csv, susceptibility_training_table.csv]
2026-10-02 updated and organized
    [65 Years of Weather Data Bangladesh (1948 - 2013).csv, COMBINED-WL-from-Altimetry_S1_S2-2008-2022_Bahadurabad.csv, COMBINED_Q_from-Altimetry_S1_S2_2008-2022-Bahadurabad.csv, Own_Rated_Q_2008-2022_Bahadurabad.csv, Q-from-Altimetry_2008-2022_Bahadurabad.csv, Q-from-S1_S2_2016-2022_Bahadurabad.csv, S1-TH-timeseries.csv, T1_dataset_summary.csv]
