Srabon-bot/Aquaguard/(notices)

Notices in the files:
new_models/AquaGuard — Machine Learning Module PRD.md:
The dataset is available under CC BY 4.0.
The dataset is released under CC BY 4.0.
